KamilWuu/Robal-2.0/docs/math/47e88c19-b6d4-4813-9f29-f112e6b49282.pdf

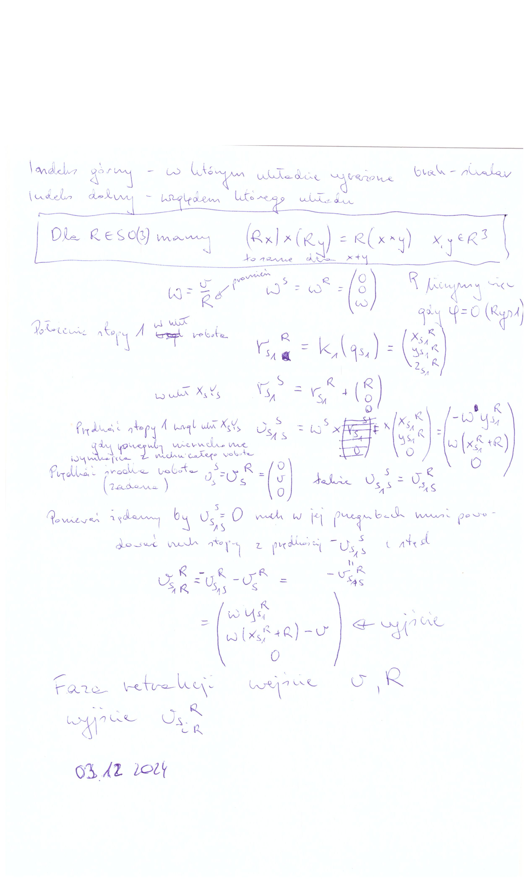
[picture p1: page 1]
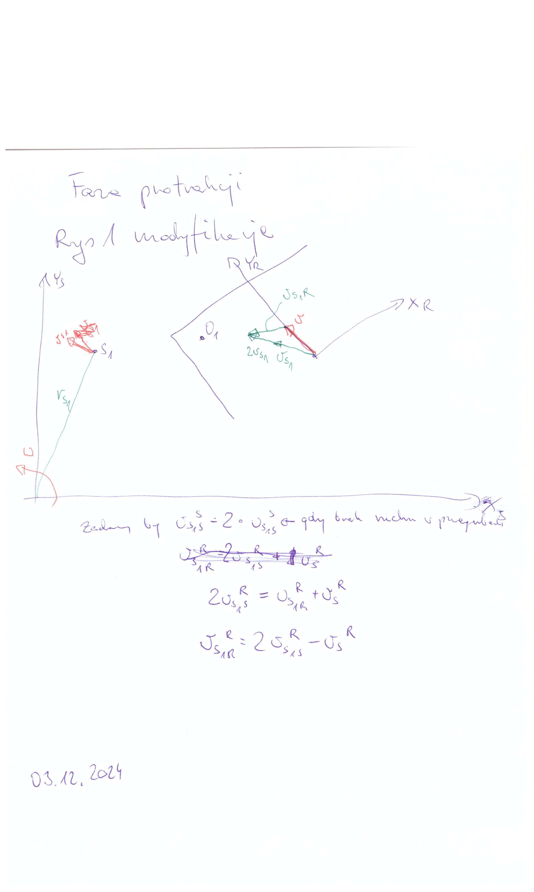
[picture p2: page 2]
