KamilWuu/Robal-2.0/docs/pictures/robal_power_board.png

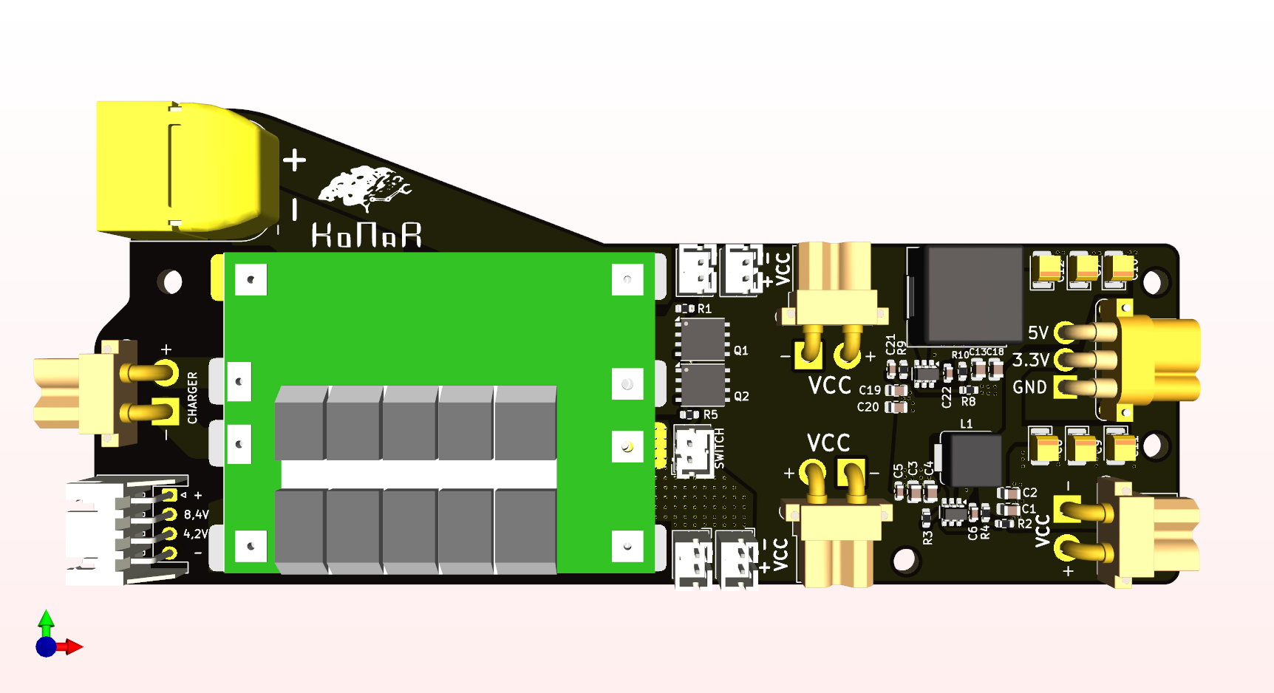
docs/pictures/robal_power_board.png
