KamilWuu/Robal-2.0/docs/pictures/robal_power_board_4.png

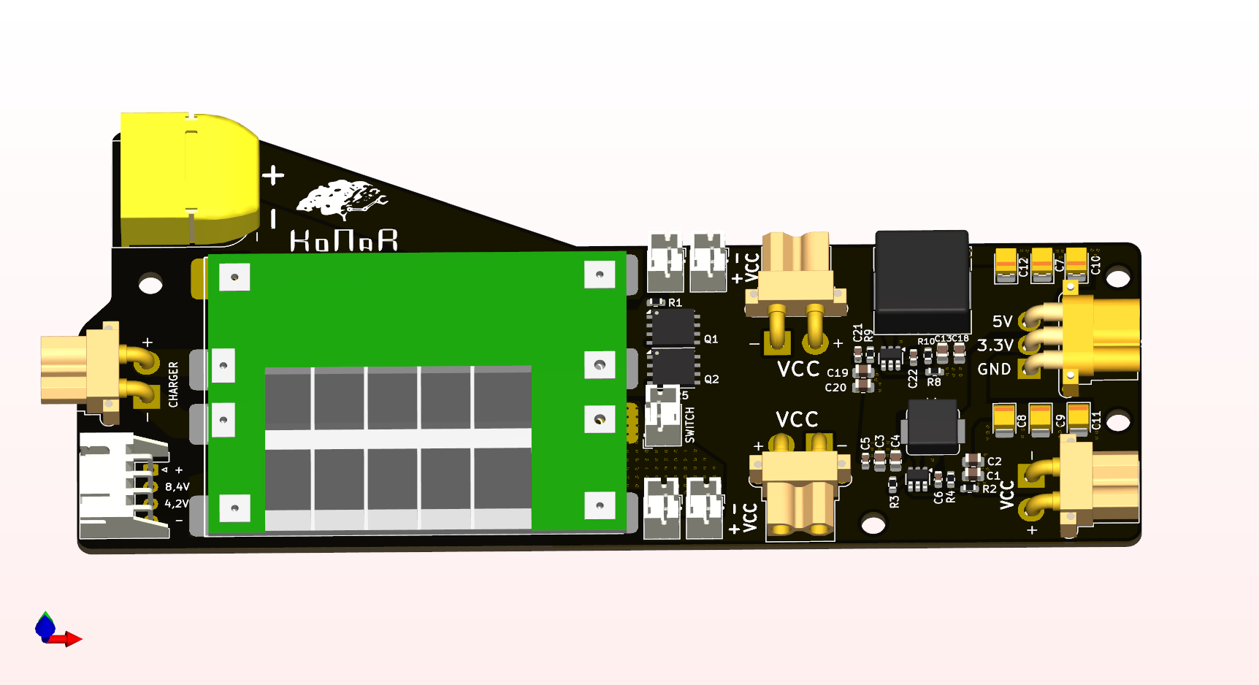
docs/pictures/robal_power_board_4.png
