KamilWuu/Robal-2.0/docs/pictures/robal_rpi_ioBoard_4.png

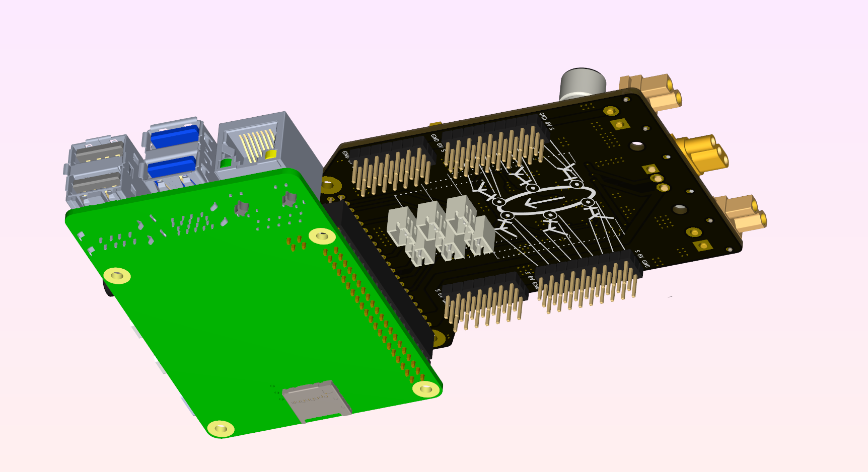
docs/pictures/robal_rpi_ioBoard_4.png
