KamilWuu/Robal-2.0/electronics/robal_power_board/5vsd_sketch.dxf

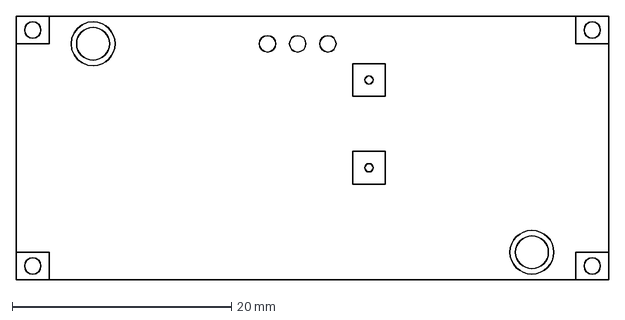
[picture p12: CAD file, 2024-07-06]
electronics/robal_power_board/5vsd_sketch.dxf
54.0 x 24.0 mm
