KamilWuu/Robal-2.0/electronics/robal_rpi_ioBoard/robal_rpi_ioBoard.step

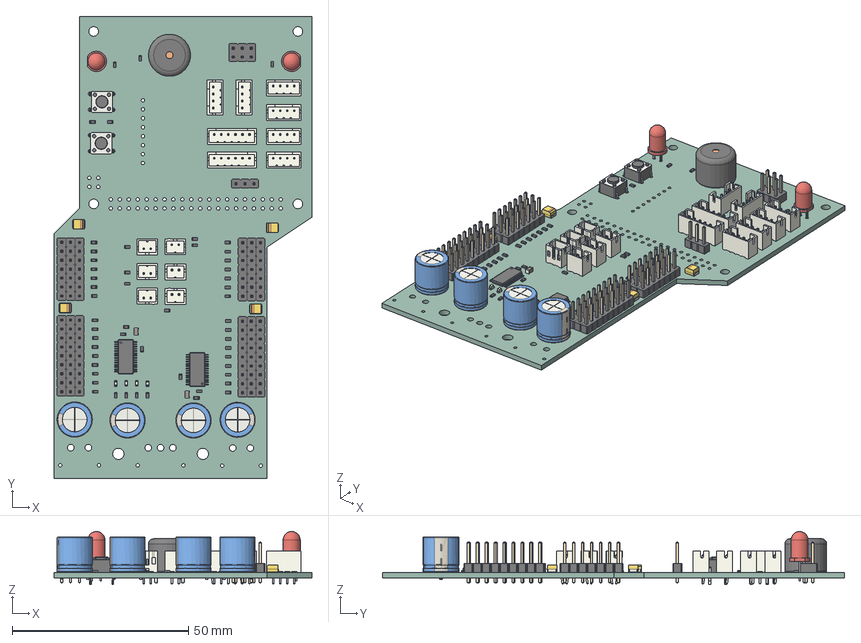
[picture p13: CAD file, 2024-08-12]
electronics/robal_rpi_ioBoard/robal_rpi_ioBoard.step
73.2 x 131.2 x 15.1 mm
R_0603_1608Metric x 53
LED_0603_1608Metric x 4
CP_EIA_3528_21_Kemet_B x 4
PinHeader_1x03_P254mm_Vertical
PinHeader_1x09_P254mm_Vertical x 6
PinHeader_1x07_P254mm_Vertical x 6
JST_B4B_PH_K x 6
LED_D5.0mm x 2
JST_B2B_PH_K x 6
JST_B6B_PH_K x 2
C_0805_2012Metric x 2
CP_Radial_D100mm_P750mm x 4
PinHeader_2x03_P254mm_Vertical
Buzzer_12x95RM76
SW_PUSH_6mm x 2
TSSOP_28_44x97mm_P065mm x 2
robal_rpi_ioBoard_PCB
