KamilWuu/Robal-2.0/electronics/step/MR30PW-FB v2.step

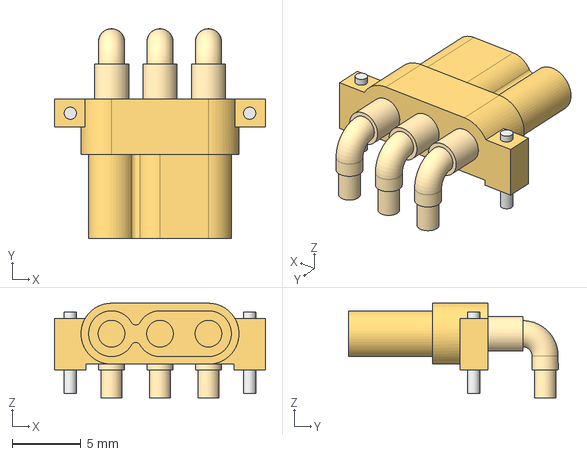
[picture p14: CAD file, 2024-07-27]
electronics/step/MR30PW-FB v2.step
15.3 x 15.2 x 6.87 mm
