KamilWuu/Robal-2.0/mechanics/mini_robal/podstawa.stl

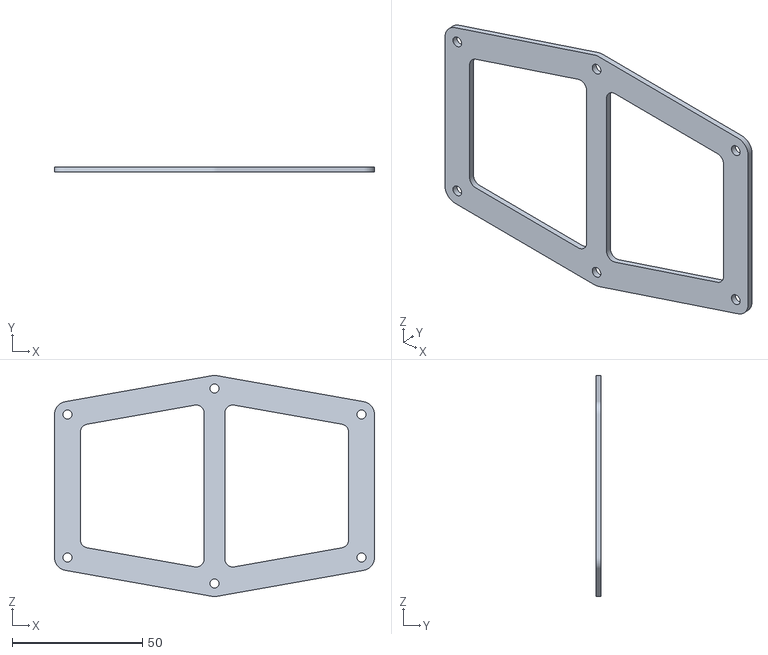
[picture p15: CAD file, 2024-10-20]
mechanics/mini_robal/podstawa.stl
123.0 x 2.00 x 85.0
