KamilWuu/Robal-2.0/mechanics/step/robal_power_board_7.step

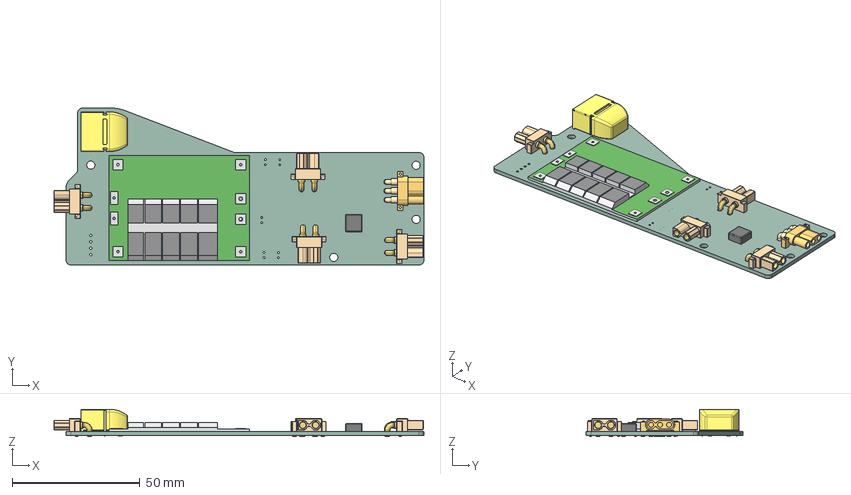
[picture p16: CAD file, 2024-09-15]
mechanics/step/robal_power_board_7.step
144.7 x 61.4 x 10.7 mm
CQ assembly
User Library-XT30PW-F x 4
60A3S_BMS
XT60PW MALE
MR30PW-FB v1
robal_power_board_PCB
