KamilWuu/Robal-2.0/mechanics/STL/but.stl

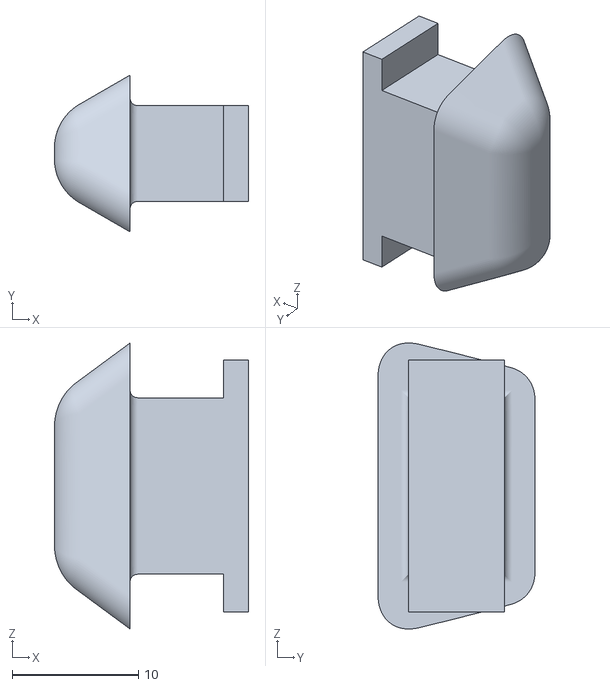
[picture p17: CAD file, 2024-12-04]
mechanics/STL/but.stl
15.4 x 12.4 x 22.7
