KamilWuu/Robal-2.0/mechanics/XT60E-M.STEP

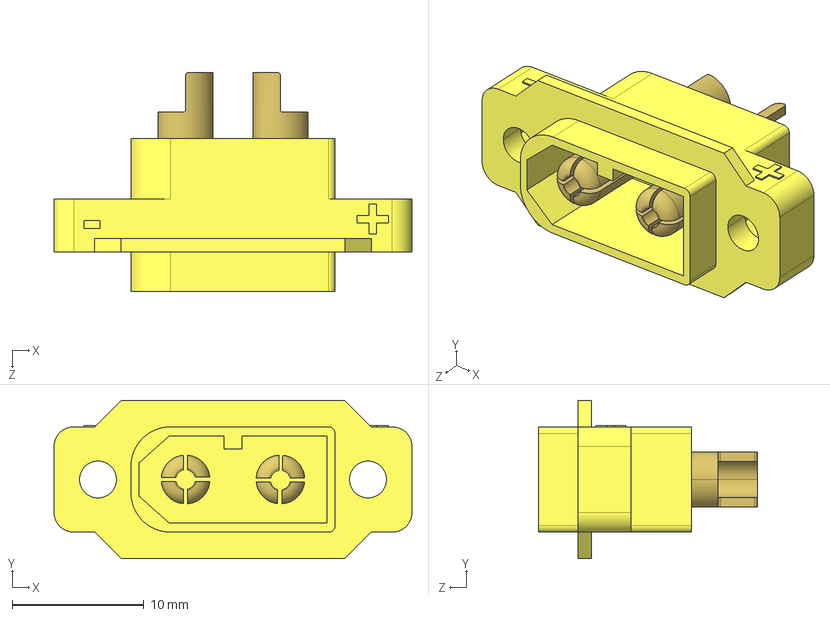
[picture p18: CAD file, 2024-10-20]
mechanics/XT60E-M.STEP
27.2 x 12.0 x 16.6 mm
