KamilWuu/Robal-2.0/electronics/robal_power_board/bms_sketch.dxf

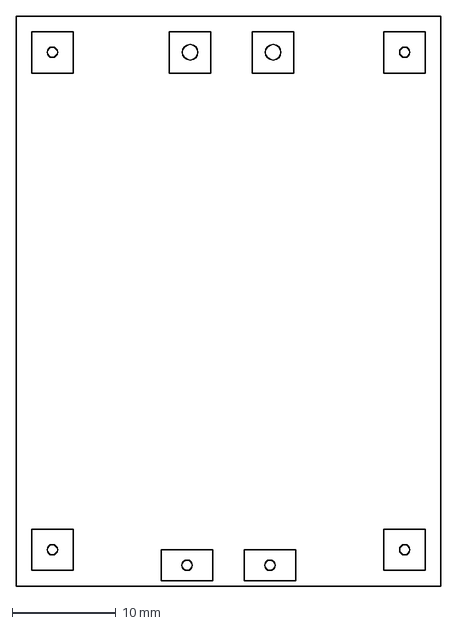
[picture p19: CAD file, 2024-07-06]
electronics/robal_power_board/bms_sketch.dxf
41.0 x 55.0 mm
