KamilWuu/Robal-2.0/electronics/step/XT30PW-F.STEP

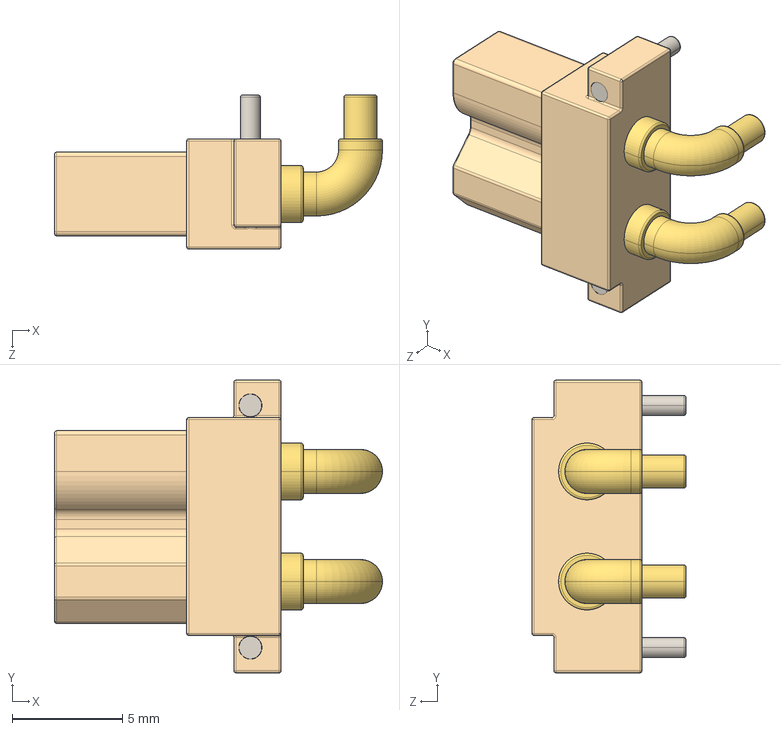
[picture p20: CAD file, 2024-07-27]
electronics/step/XT30PW-F.STEP
14.9 x 13.3 x 7.00 mm
