KamilWuu/Robal-2.0/mechanics/mini_robal/mini_noga.stl

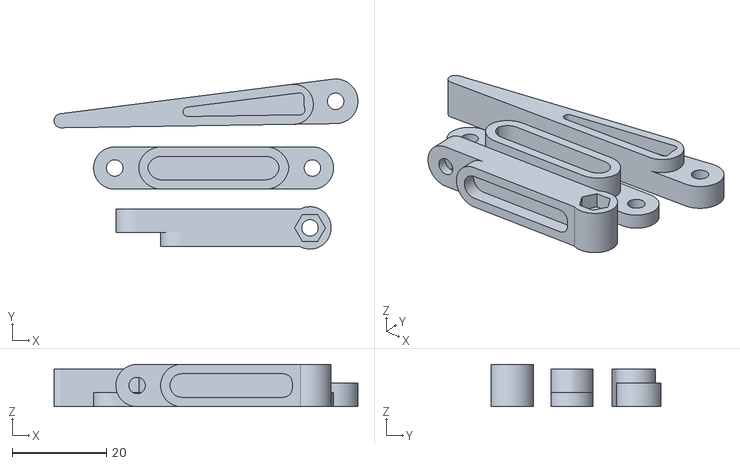
[picture p21: CAD file, 2024-10-20]
mechanics/mini_robal/mini_noga.stl
64.6 x 36.1 x 9.00
