KamilWuu/Robal-2.0/mechanics/rpi_board_obrys.dxf

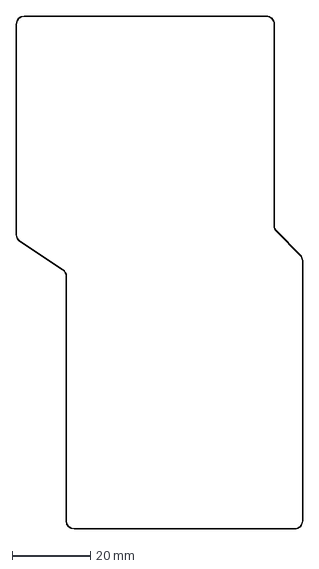
[picture p22: CAD file, 2024-08-12]
mechanics/rpi_board_obrys.dxf
73.3 x 131.2 mm
