KamilWuu/Robal-2.0/mechanics/STL/dol.stl

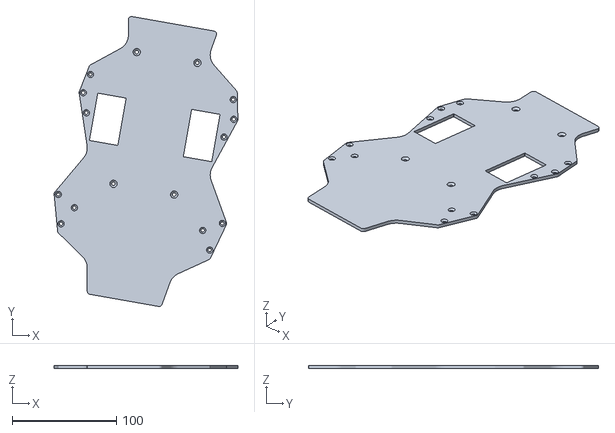
[picture p23: CAD file, 2024-10-29]
mechanics/STL/dol.stl
175.9 x 277.6 x 3.00
