KamilWuu/Robal-2.0/electronics/step/cewka.stp

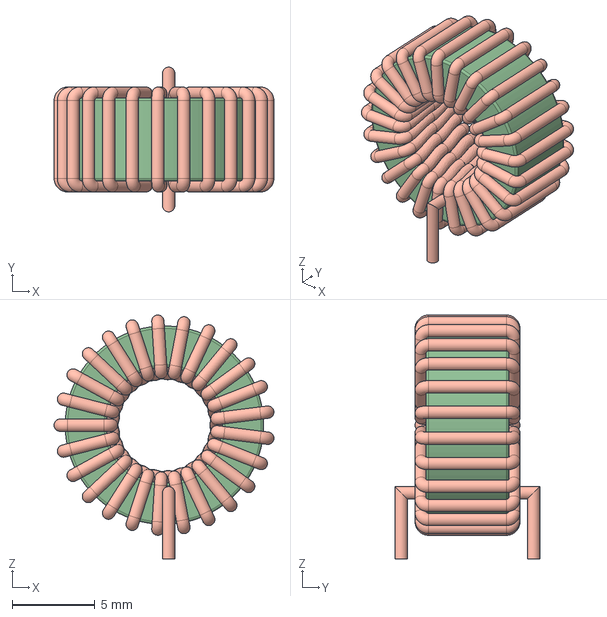
[picture p24: CAD file, 2024-07-13]
electronics/step/cewka.stp
13.3 x 8.75 x 14.8 mm
