KamilWuu/Robal-2.0/mechanics/Micro Limit Switch.STEP

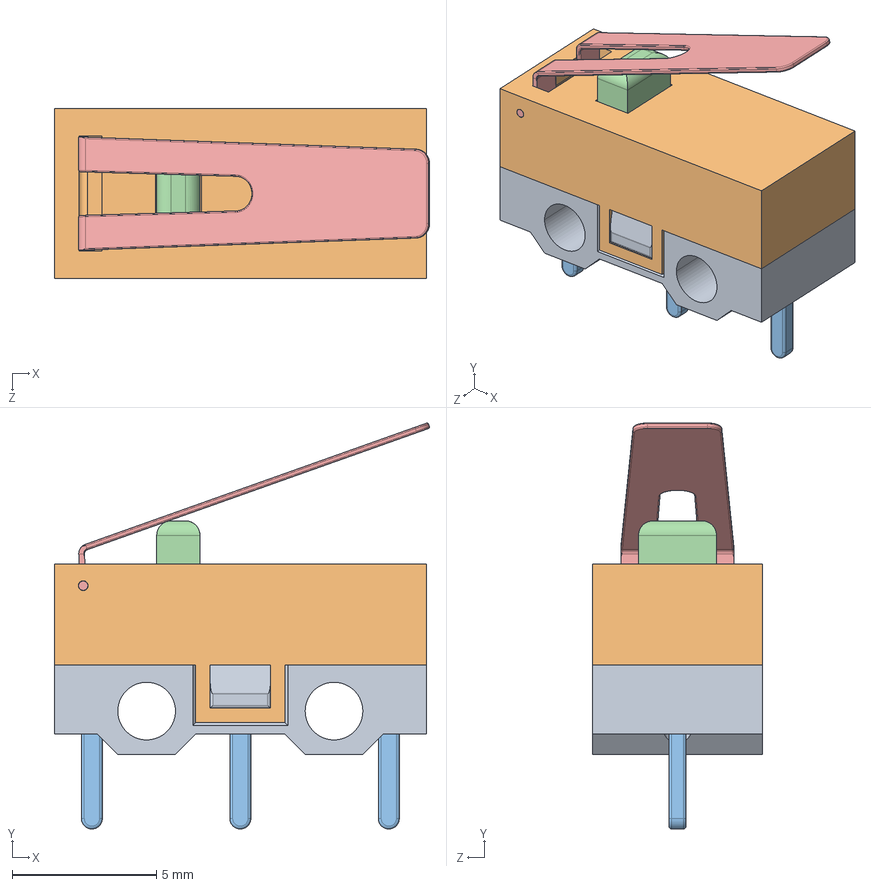
[picture p25: CAD file, 2024-07-24]
mechanics/Micro Limit Switch.STEP
13.0 x 14.1 x 5.90 mm
Bottom
Top
Pins x 3
Button
Lever
