KamilWuu/Robal-2.0/mechanics/STL/gora.stl

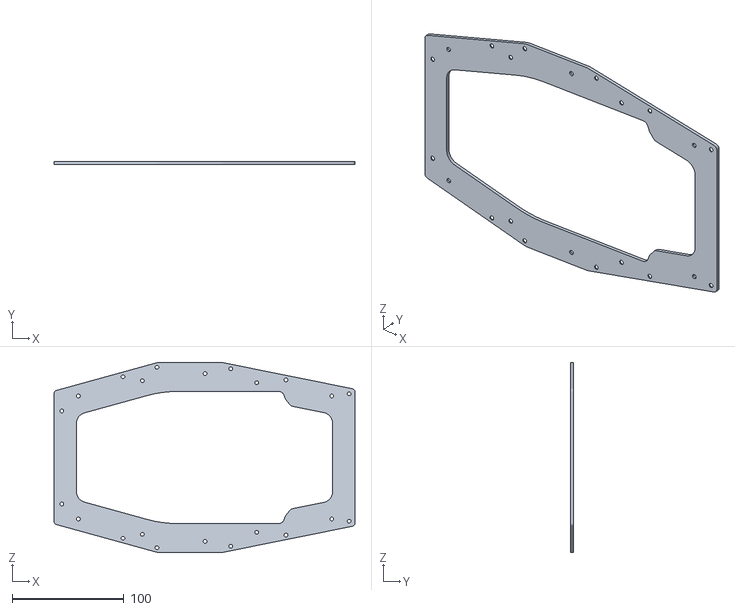
[picture p26: CAD file, 2024-10-29]
mechanics/STL/gora.stl
269.1 x 2.60 x 170.0
