KamilWuu/Robal-2.0/electronics/step/XT60PW FEMALE.STEP

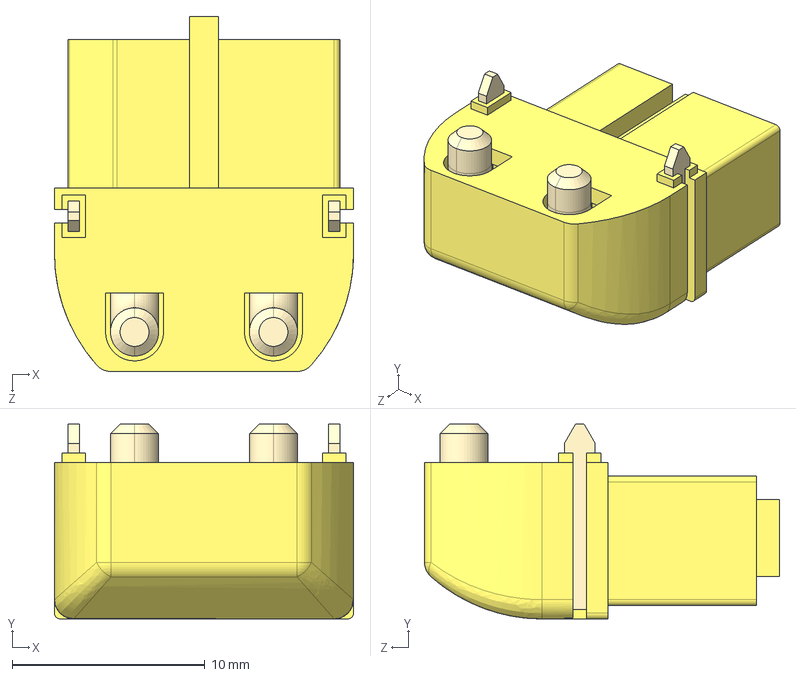
[picture p27: CAD file, 2024-07-06]
electronics/step/XT60PW FEMALE.STEP
15.5 x 10.1 x 18.4 mm
