KamilWuu/Robal-2.0/mechanics/60A3S_BMS.stp

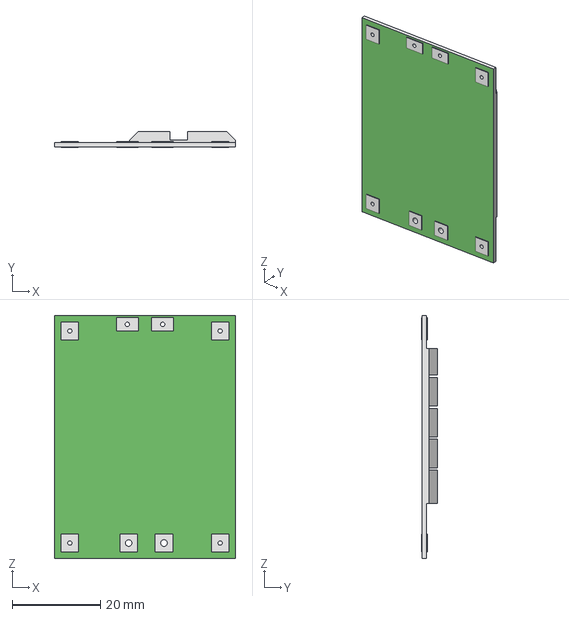
[picture p28: CAD file, 2024-07-06]
mechanics/60A3S_BMS.stp
41.0 x 3.70 x 55.0 mm
