KamilWuu/Robal-2.0/mechanics/STL/pokrywa.3mf

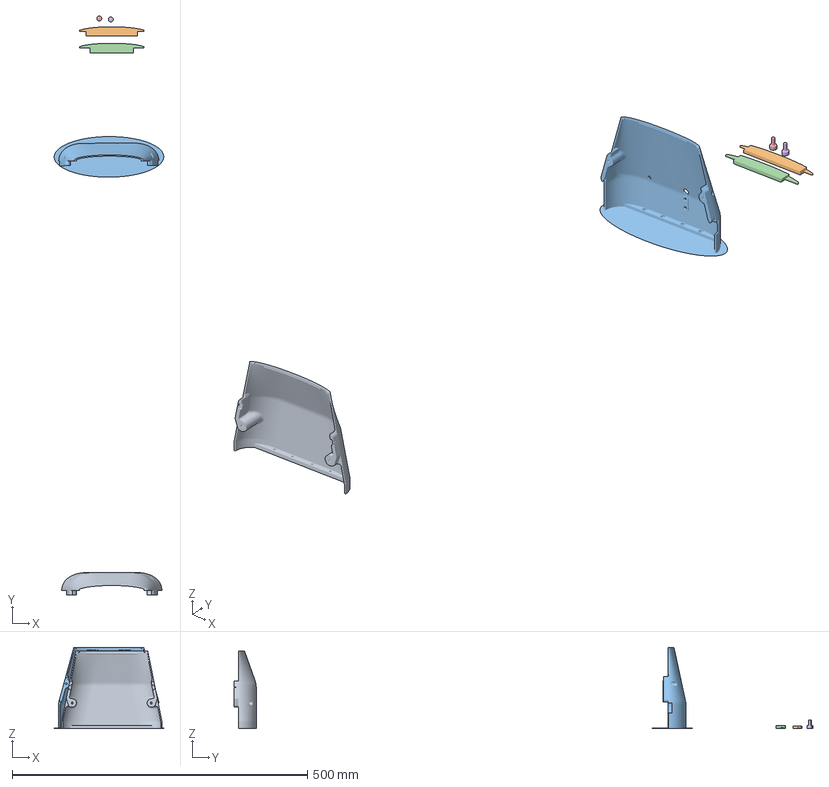
[picture p29: CAD file, 2024-10-27]
mechanics/STL/pokrywa.3mf
185.7 x 980.9 x 137.7 mm
pokrywa.stl_B
pokrywa_gorna_tyl.stl
Assembly
pokrywa_gorna_przod.stl
przycisk.stl x 2
