KamilWuu/Robal-2.0/electronics/step/Amass_XT30PW-M_pcb solder.stp

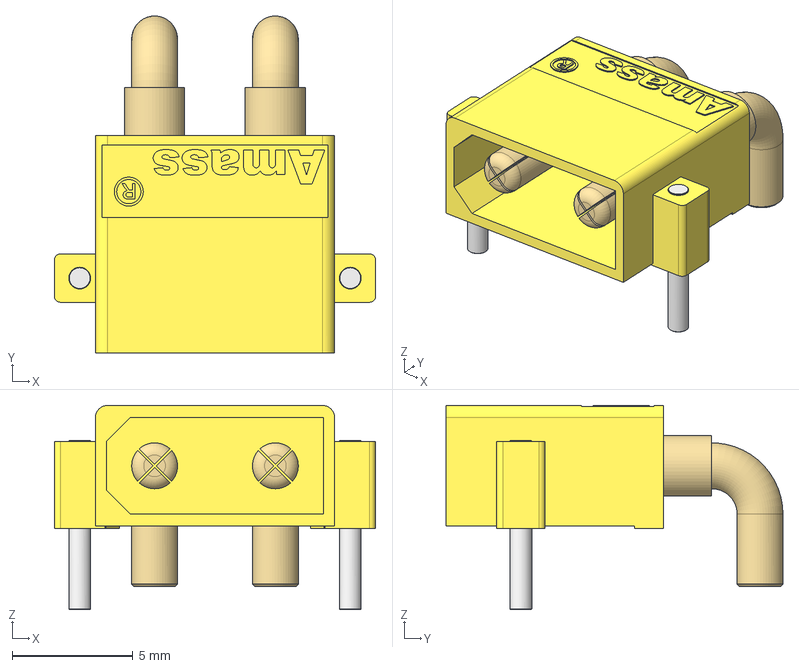
[picture p30: CAD file, 2024-07-06]
electronics/step/Amass_XT30PW-M_pcb solder.stp
13.3 x 13.9 x 8.45 mm
