KamilWuu/Robal-2.0/mechanics/STL/pokrywa_gorna_tyl.stl

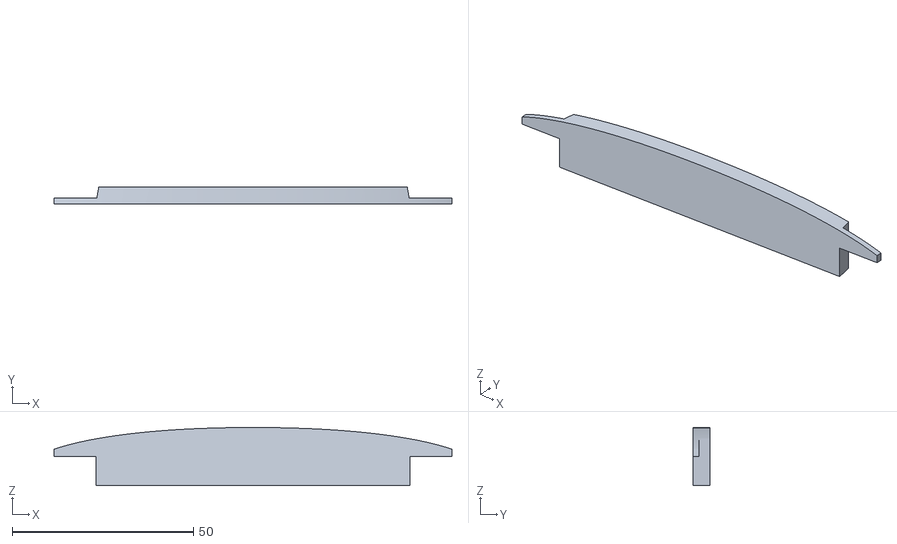
[picture p31: CAD file, 2024-10-27]
mechanics/STL/pokrywa_gorna_tyl.stl
109.7 x 4.58 x 16.0
