KamilWuu/Robal-2.0/electronics/step/MR30PW.step

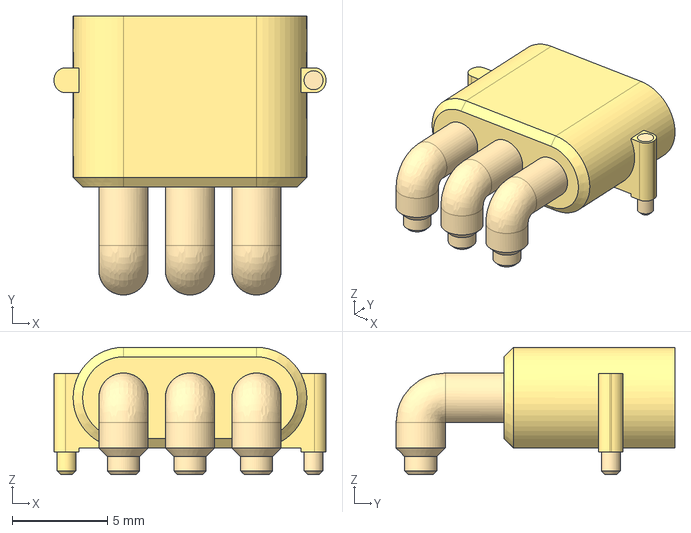
[picture p32: CAD file, 2024-07-06]
electronics/step/MR30PW.step
14.3 x 14.7 x 6.70 mm
