KamilWuu/Robal-2.0/mechanics/STL/pokrywa_gorna_przod.stl

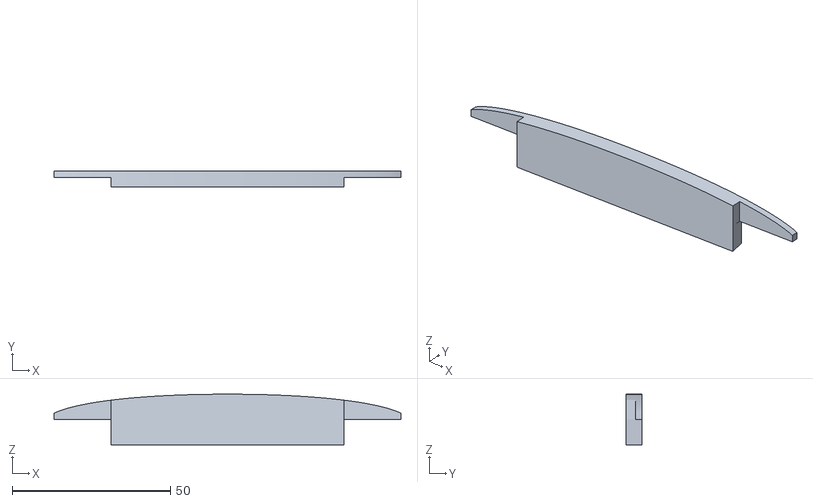
[picture p33: CAD file, 2024-10-27]
mechanics/STL/pokrywa_gorna_przod.stl
109.6 x 5.00 x 16.0
