KamilWuu/Robal-2.0/electronics/step/XT60PW MALE.STEP

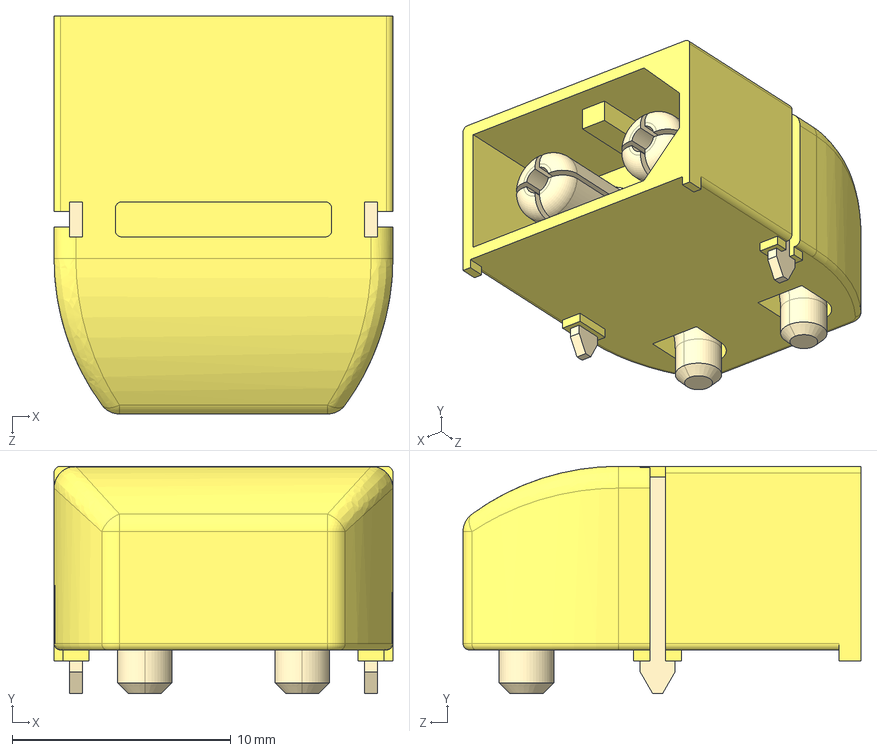
[picture p34: CAD file, 2024-07-06]
electronics/step/XT60PW MALE.STEP
15.5 x 10.4 x 18.2 mm
