KamilWuu/Robal-2.0/mechanics/STL/przycisk.stl

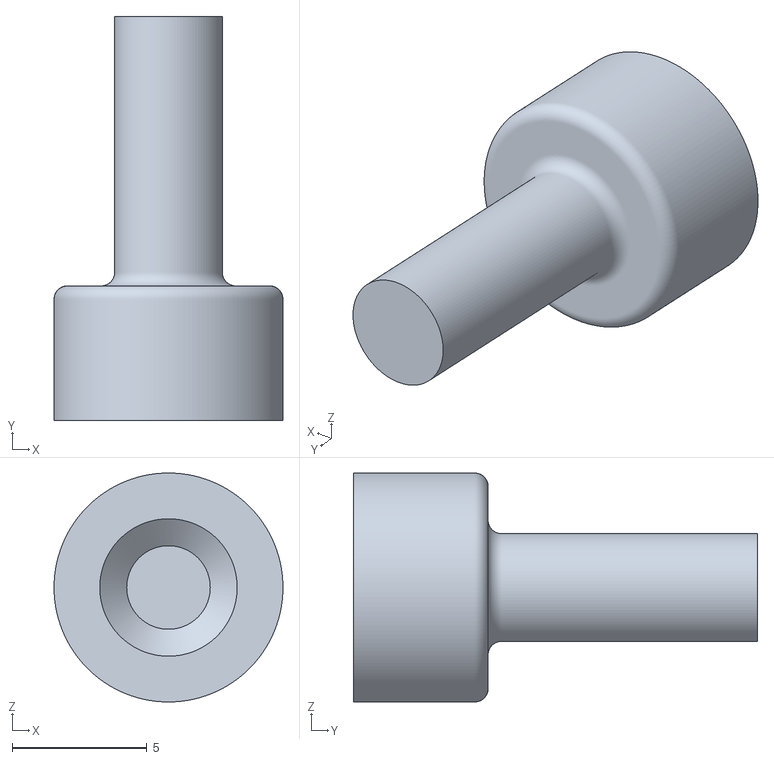
[picture p35: CAD file, 2024-10-27]
mechanics/STL/przycisk.stl
8.50 x 15.0 x 8.50
