KamilWuu/Robal-2.0/mechanics/STL/pokrywa_tyl.stl

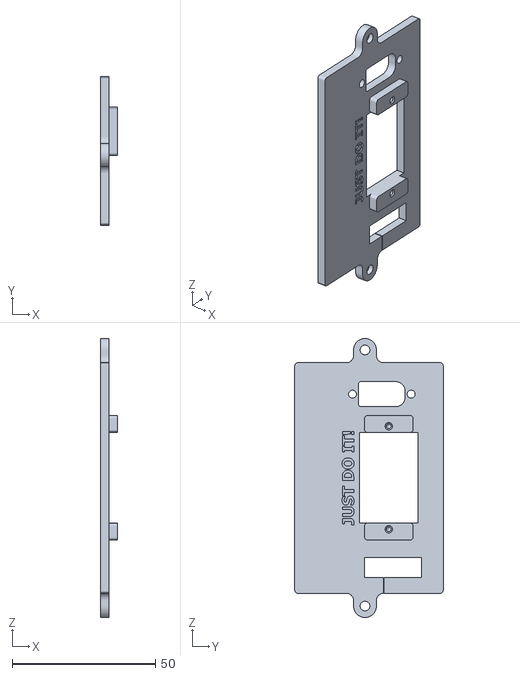
[picture p36: CAD file, 2024-10-20]
mechanics/STL/pokrywa_tyl.stl
6.00 x 51.9 x 97.5
