KamilWuu/Robal-2.0/mechanics/STL/oslona_wlacznika.stl

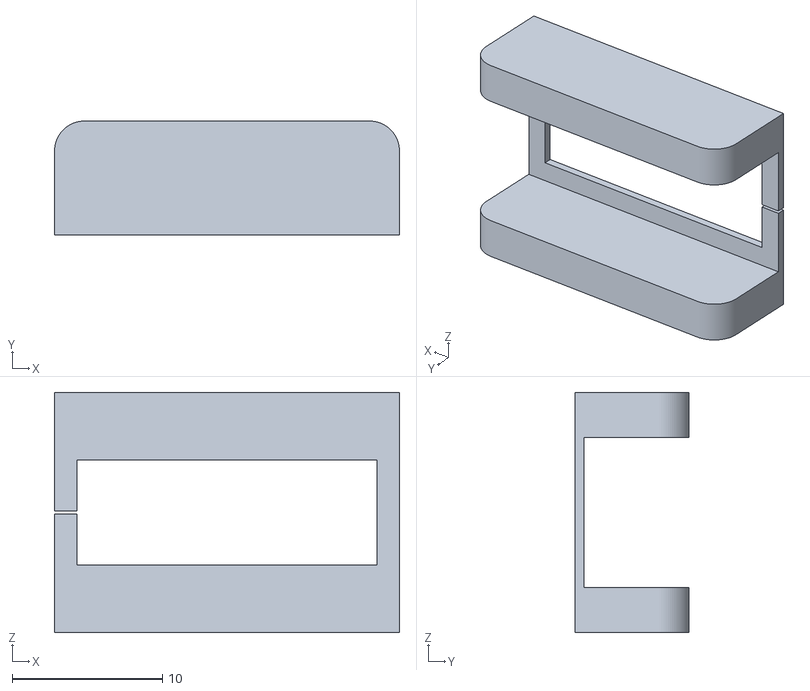
[picture p37: CAD file, 2024-10-20]
mechanics/STL/oslona_wlacznika.stl
23.0 x 7.60 x 16.0
