KamilWuu/Robal-2.0/mechanics/STL/podstawka_bateria.stl

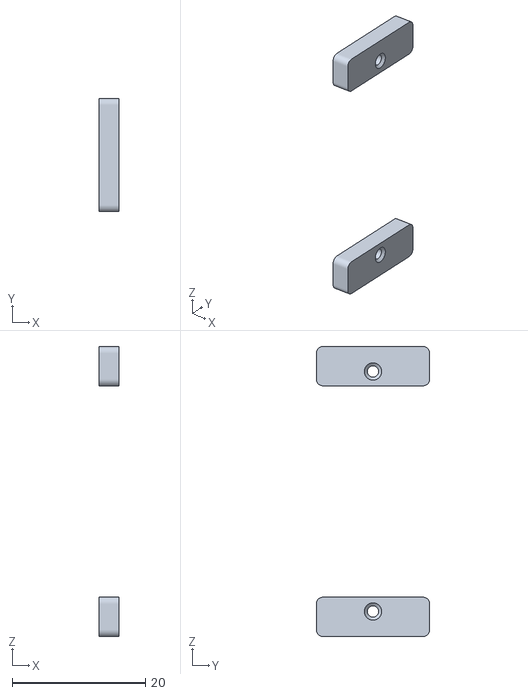
[picture p38: CAD file, 2024-10-20]
mechanics/STL/podstawka_bateria.stl
3.00 x 17.0 x 43.5
