KamilWuu/Robal-2.0/mechanics/STL/podpora_imu.stl

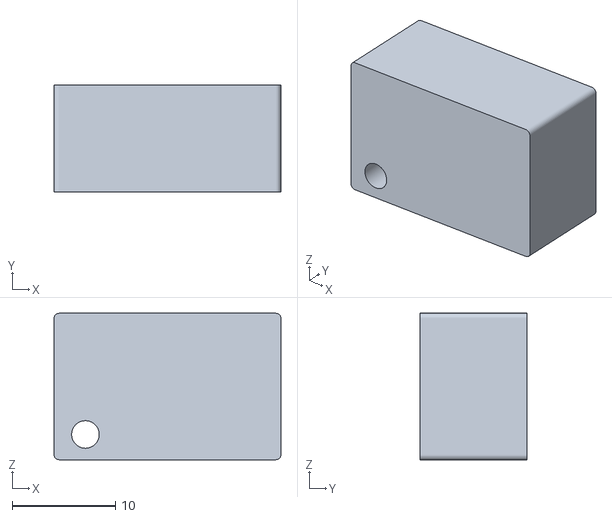
[picture p39: CAD file, 2024-10-12]
mechanics/STL/podpora_imu.stl
22.0 x 10.4 x 14.2
