KamilWuu/Robal-2.0/mechanics/STL/podstawa_rpi_1.stl

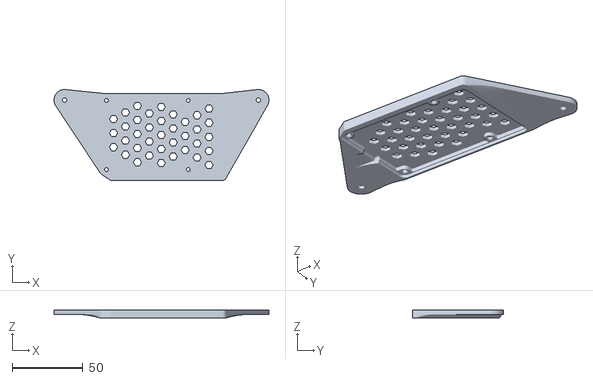
[picture p40: CAD file, 2024-09-15]
mechanics/STL/podstawa_rpi_1.stl
152.4 x 64.5 x 5.50
