KamilWuu/Robal-2.0/mechanics/STL/podstawa_rpi_board_2.stl

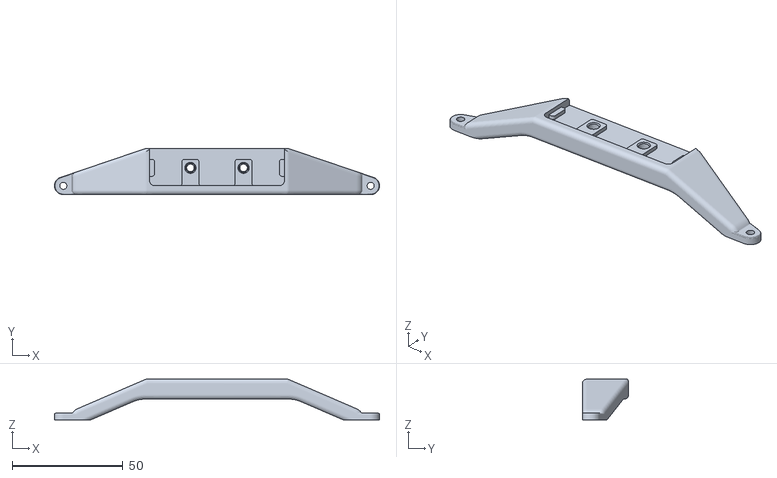
[picture p41: CAD file, 2024-09-15]
mechanics/STL/podstawa_rpi_board_2.stl
146.7 x 20.9 x 18.4
