KamilWuu/Robal-2.0/mechanics/STL/rpi_wspornik.stl

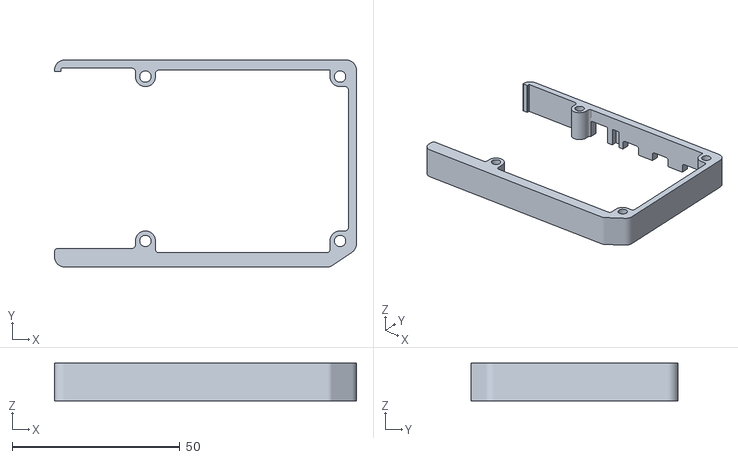
[picture p42: CAD file, 2024-09-15]
mechanics/STL/rpi_wspornik.stl
90.0 x 61.7 x 11.2
