KamilWuu/Robal-2.0/mechanics/STL/klips.stl

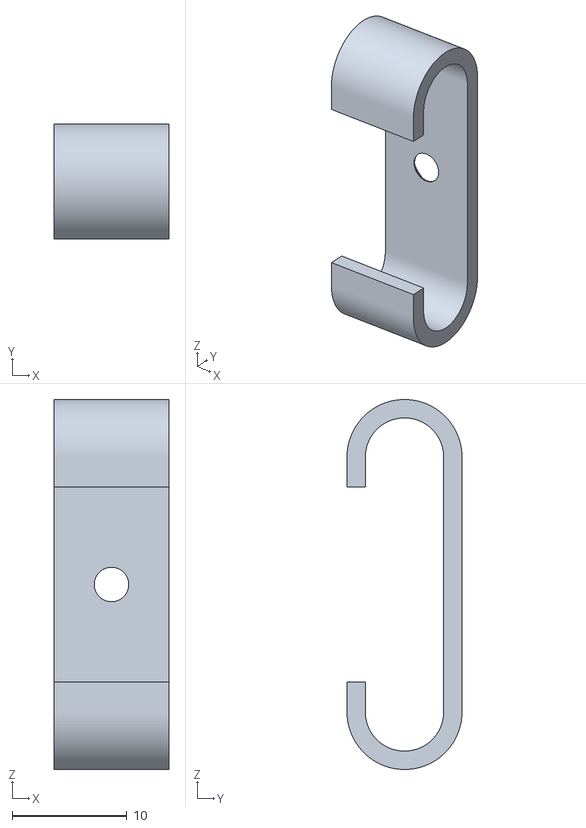
[picture p43: CAD file, 2024-08-08]
mechanics/STL/klips.stl
10.0 x 10.0 x 32.2
