KamilWuu/Robal-2.0/mechanics/STL/czlon3_lewy.3mf

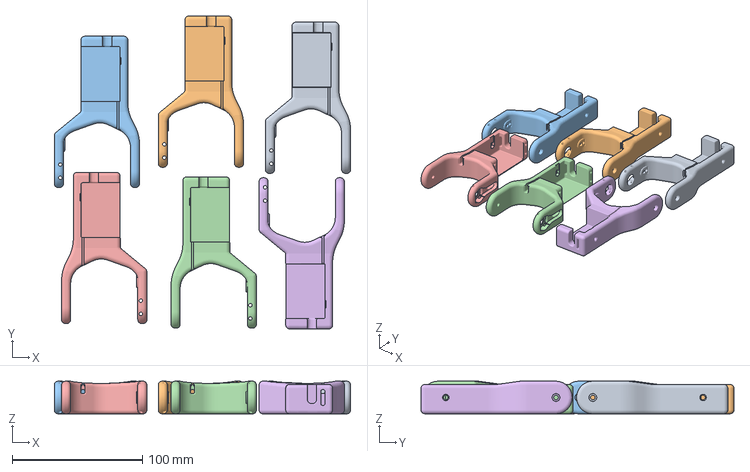
[picture p44: CAD file, 2024-08-08]
mechanics/STL/czlon3_lewy.3mf
227.2 x 240.0 x 25.0 mm
czlon2_lewy x 6
