KamilWuu/Robal-2.0/mechanics/STL/organizer_1.3mf

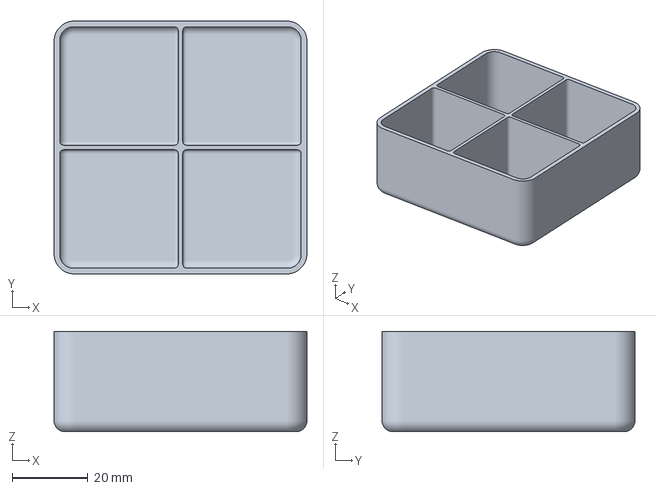
[picture p45: CAD file, 2024-08-08]
mechanics/STL/organizer_1.3mf
66.6 x 66.6 x 26.5 mm
