KamilWuu/Robal-2.0/mechanics/STL/ochraniach_1.stl

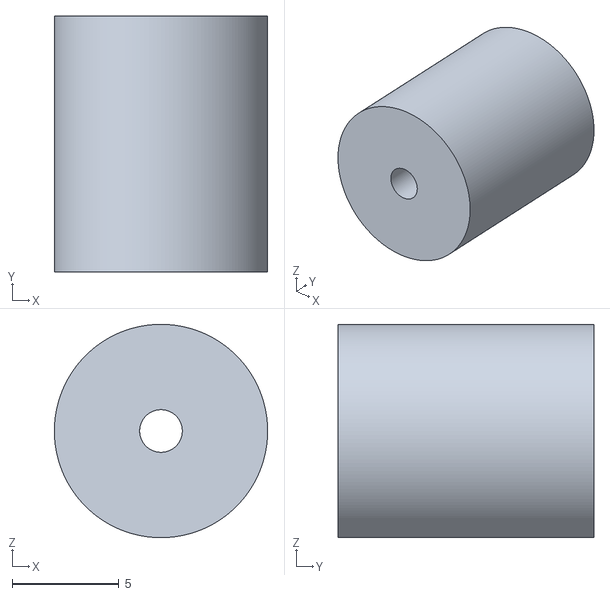
[picture p46: CAD file, 2024-08-08]
mechanics/STL/ochraniach_1.stl
10.0 x 12.0 x 10.0
