KamilWuu/Robal-2.0/mechanics/STL/czlon2_lewy.3mf

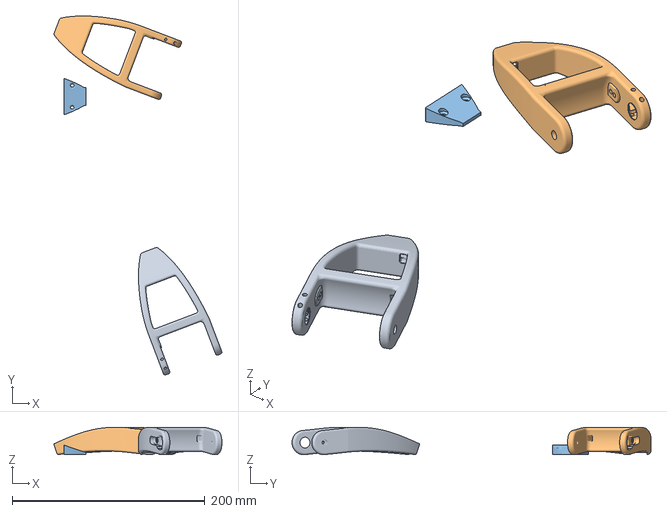
[picture p47: CAD file, 2024-08-08]
mechanics/STL/czlon2_lewy.3mf
174.1 x 372.2 x 28.2 mm
czlon3_lewy x 2
czlon3_lewy_pokrywa.stl
