KamilWuu/Robal-2.0/mechanics/STL/ochraniach_2.stl

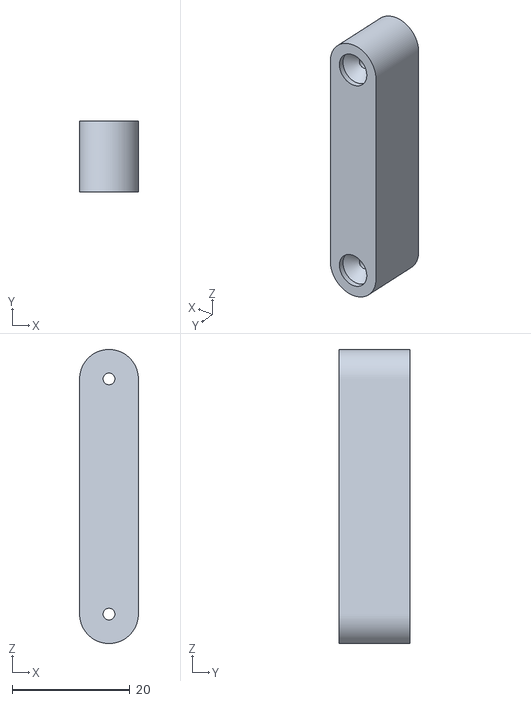
[picture p48: CAD file, 2024-08-08]
mechanics/STL/ochraniach_2.stl
10.0 x 12.0 x 50.0
