KamilWuu/Robal-2.0/mechanics/STL/kulka.stl

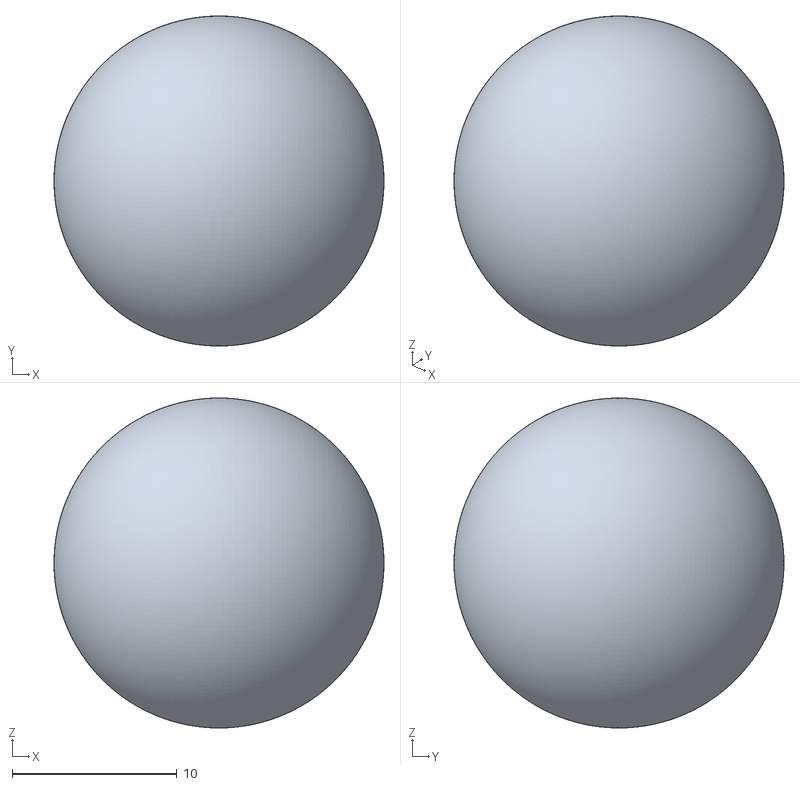
[picture p49: CAD file, 2024-08-08]
mechanics/STL/kulka.stl
20.0 x 20.0 x 20.0
