KamilWuu/Robal-2.0/mechanics/STL/uchwyt_li_pol.stl

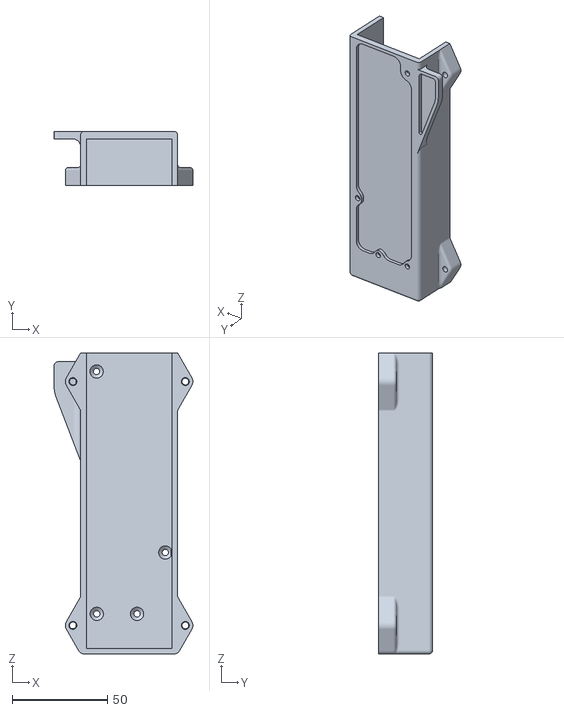
[picture p50: CAD file, 2024-08-08]
mechanics/STL/uchwyt_li_pol.stl
72.9 x 28.5 x 158.0
