KamilWuu/Robal-2.0/mechanics/STL/angle_servo.stl

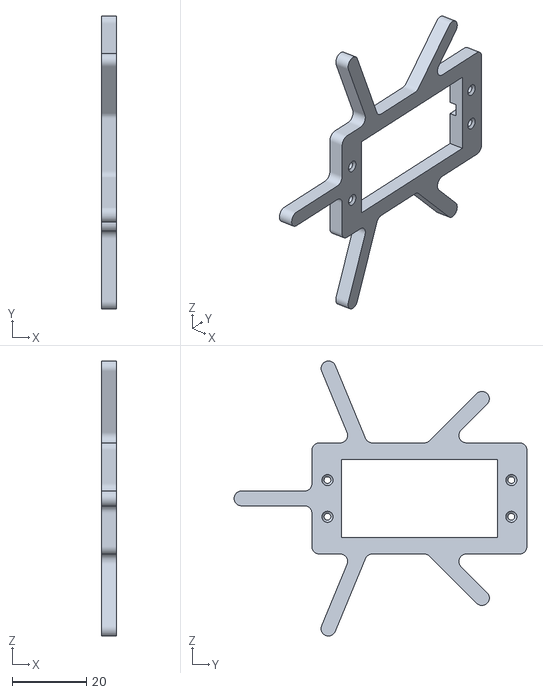
[picture p51: CAD file, 2024-08-08]
mechanics/STL/angle_servo.stl
4.00 x 79.0 x 74.2
