KamilWuu/Robal-2.0/mechanics/STL/podkladka_switch.stl

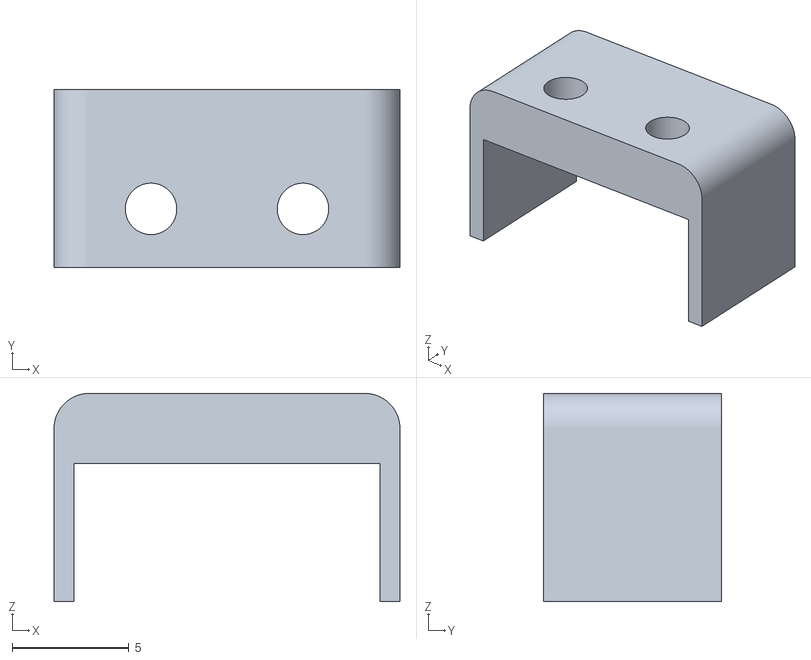
[picture p52: CAD file, 2024-08-08]
mechanics/STL/podkladka_switch.stl
14.8 x 7.60 x 8.90
