KamilWuu/Robal-2.0/mechanics/STL/czlon3_lewy_pokrywa.stl

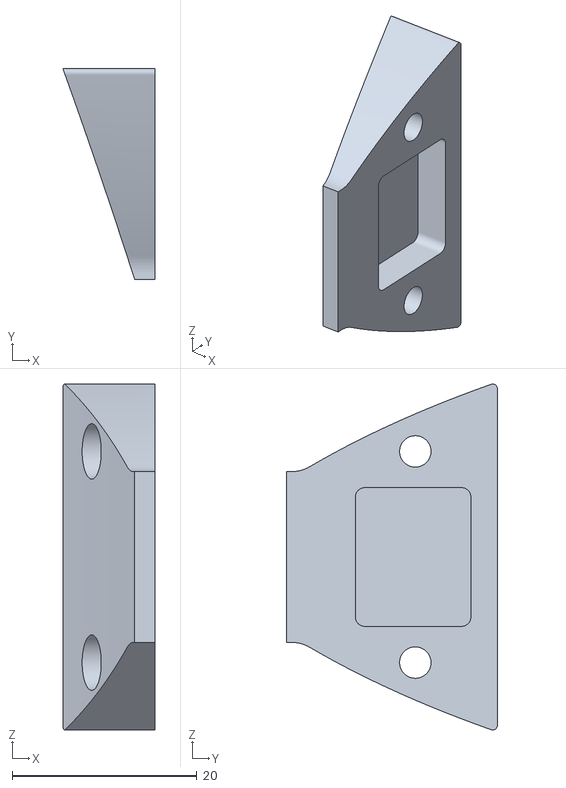
[picture p53: CAD file, 2024-08-08]
mechanics/STL/czlon3_lewy_pokrywa.stl
9.98 x 22.8 x 37.4
