KamilWuu/Robal-2.0/mechanics/STL/czlon3_lewy_color_1.stl

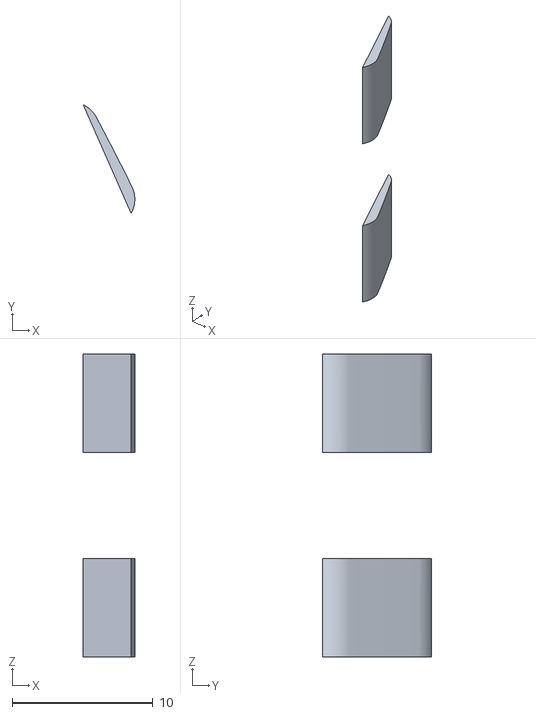
[picture p54: CAD file, 2024-08-05]
mechanics/STL/czlon3_lewy_color_1.stl
3.67 x 7.70 x 21.5
