KamilWuu/Robal-2.0/mechanics/STL/czlon2_lewy_color_2.stl

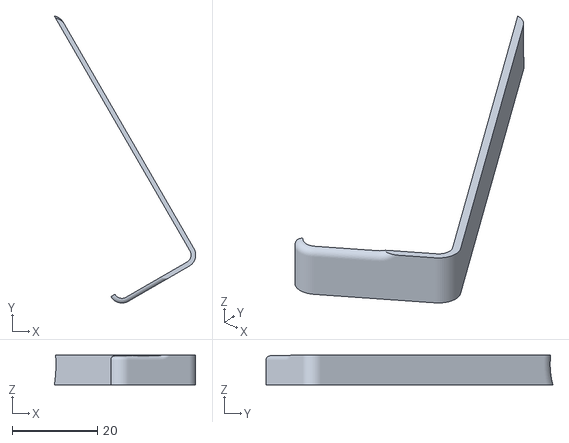
[picture p55: CAD file, 2024-08-02]
mechanics/STL/czlon2_lewy_color_2.stl
33.1 x 67.3 x 7.00
