KamilWuu/Robal-2.0/mechanics/STL/czlon2_lewy_color_1.stl

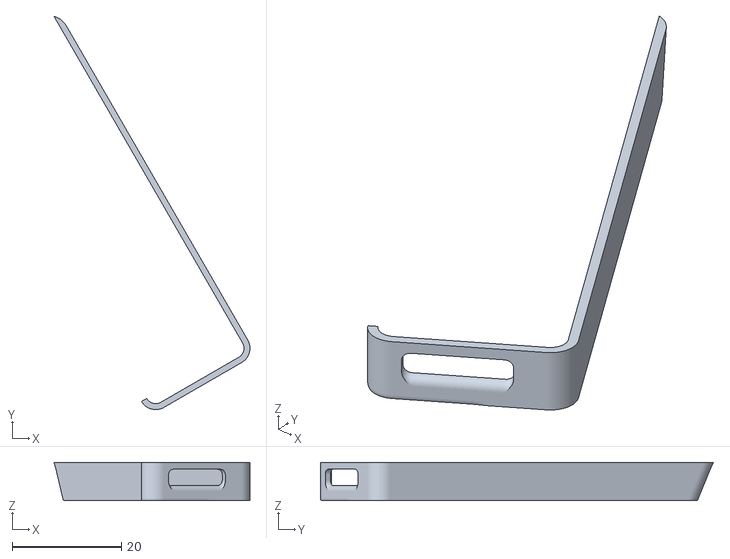
[picture p56: CAD file, 2024-08-02]
mechanics/STL/czlon2_lewy_color_1.stl
35.9 x 72.1 x 7.00
