KamilWuu/Robal-2.0/mechanics/STL/czlon1_lewy_color_3.stl

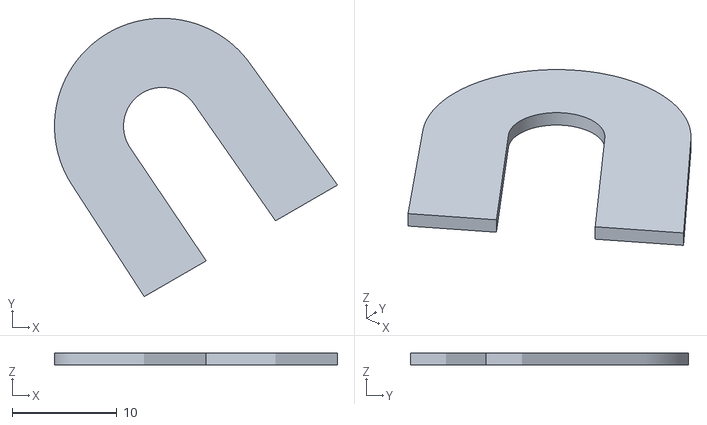
[picture p57: CAD file, 2024-07-31]
mechanics/STL/czlon1_lewy_color_3.stl
27.0 x 26.6 x 1.10
