KamilWuu/Robal-2.0/mechanics/STL/czlon1_lewy.stl

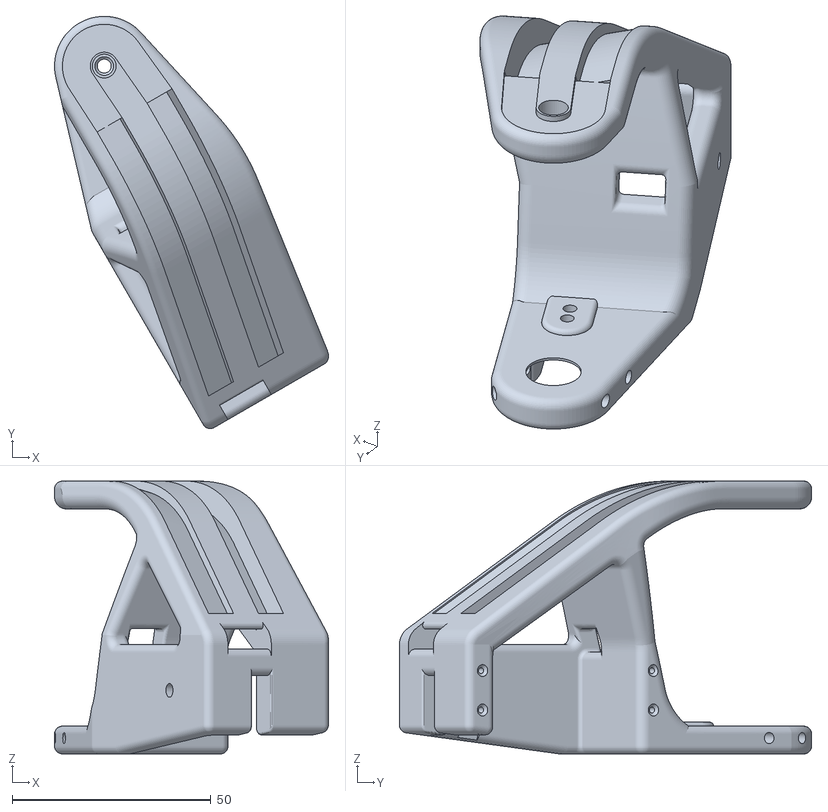
[picture p58: CAD file, 2024-07-31]
mechanics/STL/czlon1_lewy.stl
68.9 x 103.6 x 68.6
