KamilWuu/Robal-2.0/mechanics/STL/uchwyt_serwa_podwojny.3mf

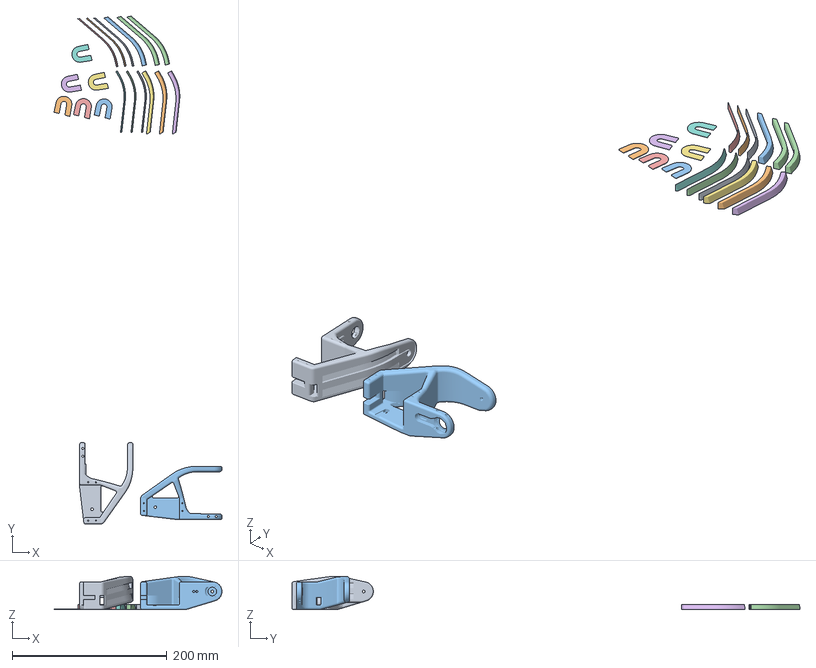
[picture p59: CAD file, 2024-07-31]
mechanics/STL/uchwyt_serwa_podwojny.3mf
216.9 x 655.7 x 43.1 mm
czlon1_prawy.stl
czlon1_lewy_color_2.stl x 6
czlon1_lewy.stl
czlon1_lewy_color_1.stl x 6
czlon1_lewy_color_3.stl x 6
