KamilWuu/Robal-2.0/mechanics/STL/czlon1_lewy_color_2.stl

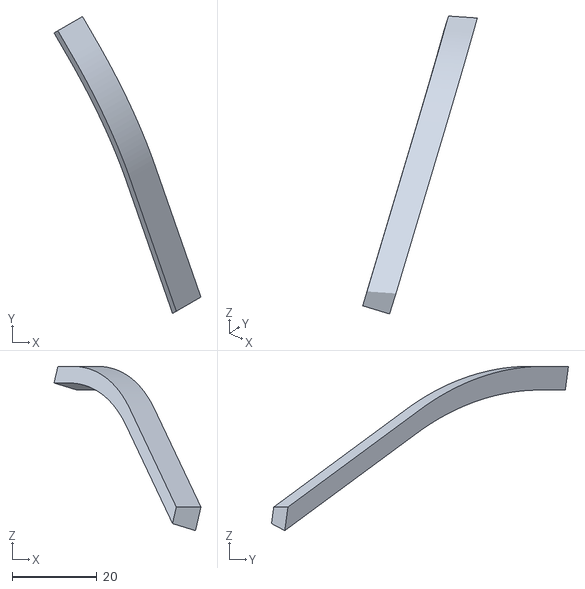
[picture p60: CAD file, 2024-07-31]
mechanics/STL/czlon1_lewy_color_2.stl
34.8 x 70.3 x 38.9
