KamilWuu/Robal-2.0/mechanics/STL/czlon1_lewy_color_1.stl

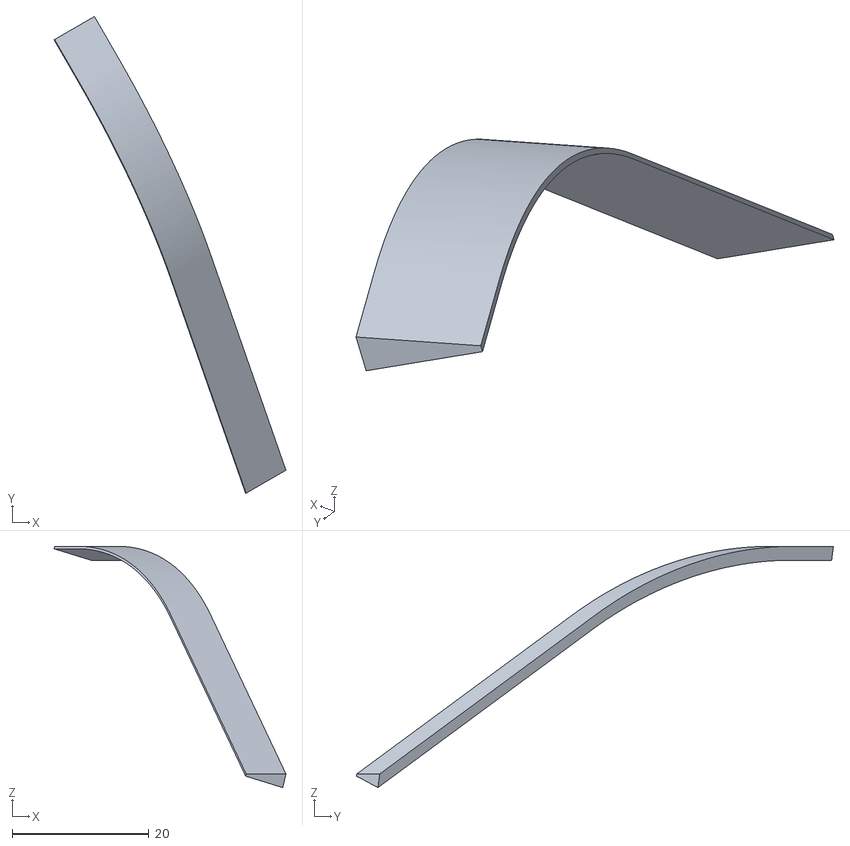
[picture p61: CAD file, 2024-07-31]
mechanics/STL/czlon1_lewy_color_1.stl
33.9 x 69.8 x 35.3
