KamilWuu/Robal-2.0/mechanics/STL/usztywnienie_3.stl

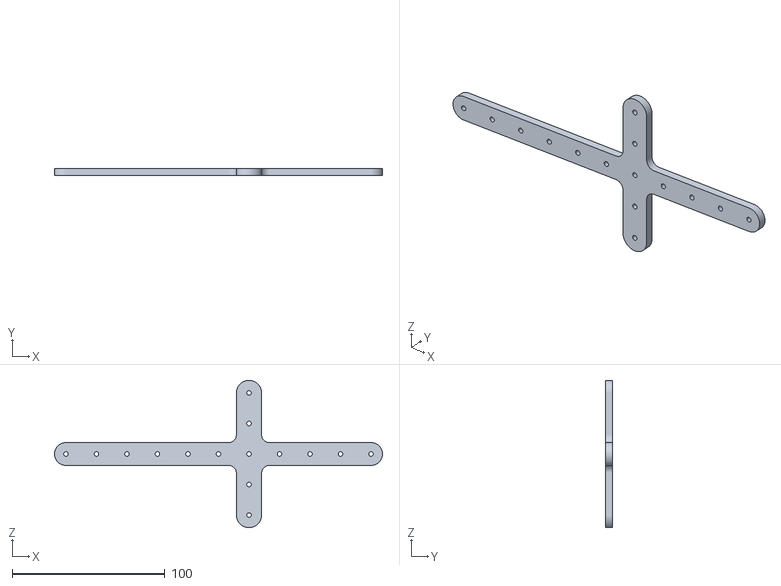
[picture p62: CAD file, 2024-07-31]
mechanics/STL/usztywnienie_3.stl
215.0 x 4.80 x 96.6
