KamilWuu/Robal-2.0/mechanics/STL/uchwyt_serwa_podwojny_MIR.stl

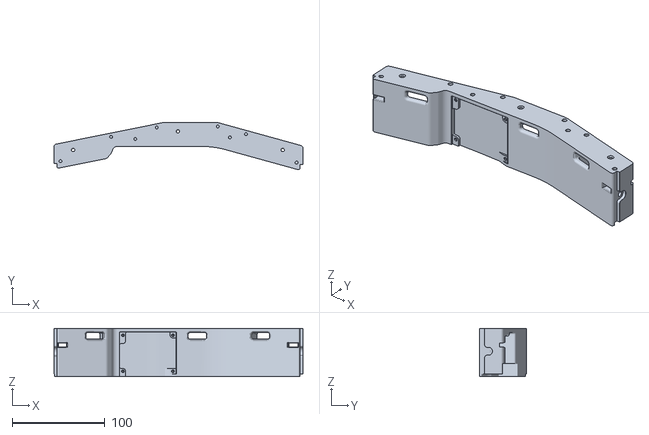
[picture p63: CAD file, 2024-07-31]
mechanics/STL/uchwyt_serwa_podwojny_MIR.stl
269.1 x 51.1 x 52.0
