KamilWuu/Robal-2.0/mechanics/STL/usztywnienie.stl

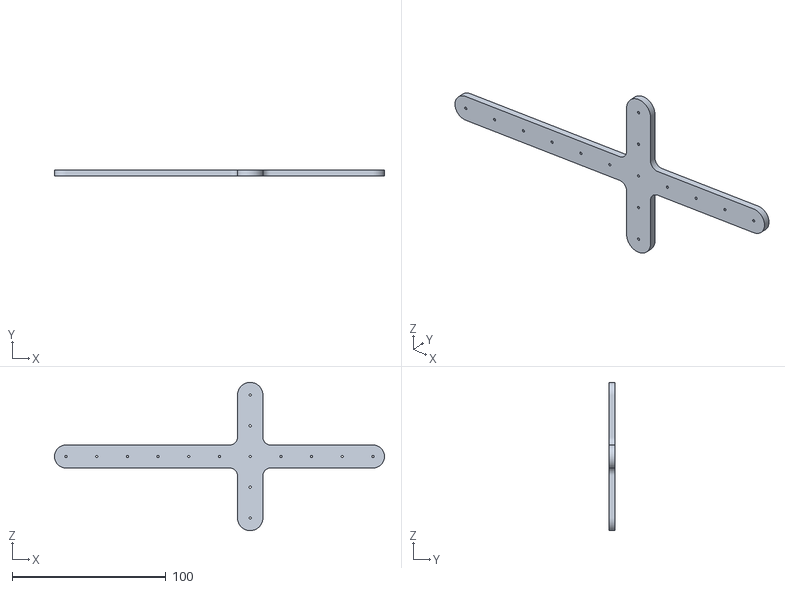
[picture p65: CAD file, 2024-07-31]
mechanics/STL/usztywnienie.stl
215.0 x 4.00 x 96.6
