KamilWuu/Robal-2.0/mechanics/STL/pokrywa_przod.stl

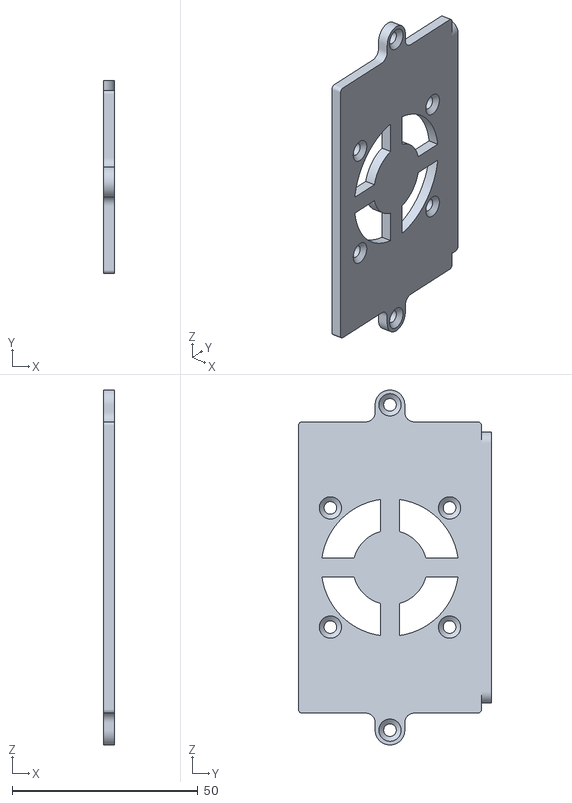
[picture p66: CAD file, 2024-07-31]
mechanics/STL/pokrywa_przod.stl
3.00 x 52.0 x 95.6
