KamilWuu/Robal-2.0/(list of files, cad)

Other CAD files:
docs/drawings/noga_pre_MIR.dwg
mechanics/STL/czlon3_lewy_but.stl
docs/drawings/OldVersions/noga_pre_MIR.0001.dwg
mechanics/60A3S_BMS.ipt
mechanics/Bashing_3S1P_11.1V_5000mAH_60c.ipt
mechanics/DC-DC Step Down Buck Converter CC-CV 300W 9A.ipt
mechanics/Lithium Battery Capacity Indicator Module.ipt
mechanics/Micro Limit Switch/Micro Limit Switch.ipt
mechanics/Micro Limit Switch/Micro Limit Switch_MIR.ipt
mechanics/Micro Limit Switch/Micro Limit Switch_MIR1.ipt
mechanics/Micro Limit Switch/OldVersions/Micro Limit Switch.0002.ipt
mechanics/OldVersions/60A3S_BMS.0001.ipt
mechanics/OldVersions/Bashing_3S1P_11.1V_5000mAH_60c.0001.ipt
mechanics/OldVersions/Lithium Battery Capacity Indicator Module.0001.ipt
mechanics/OldVersions/POKRYWA_TYLNA.0001.iam
mechanics/OldVersions/ROBAL_2.0_assembly_01.0017.iam
mechanics/OldVersions/RPI.0004.iam
mechanics/OldVersions/RPI_2.0009.iam
mechanics/OldVersions/Standard-Servo.0011.ipt
mechanics/OldVersions/Standard-Servo_MIR3.0001.ipt
mechanics/OldVersions/blacha_dolna_pre.0003.ipt
mechanics/OldVersions/blacha_gorna_pre.0002.ipt
mechanics/OldVersions/but.0007.ipt
mechanics/OldVersions/but_MIR1.0001.ipt
mechanics/OldVersions/cewka.0003.ipt
mechanics/OldVersions/czlon2_pre.0020.ipt
mechanics/OldVersions/czlon2_pre_MIR2.0003.ipt
mechanics/OldVersions/czlon2_pre_dol.0004.ipt
mechanics/OldVersions/czlon3_pre.0023.ipt
mechanics/OldVersions/czlon3_pre_MIR1.0004.ipt
mechanics/OldVersions/czlon4_2_wciecie_1.0003.ipt
mechanics/OldVersions/czlon4_pre.0003.ipt
mechanics/OldVersions/czlon4_pre_2.0018.ipt
mechanics/OldVersions/czlon4_pre_2_MIR1.0002.ipt
mechanics/OldVersions/czlon4_pre_2_pokrywa.0009.ipt
mechanics/OldVersions/czlon_2_wciecie_1.0005.ipt
mechanics/OldVersions/czlon_2_wciecie_2.0005.ipt
mechanics/OldVersions/czlon_2_wciecie_3.0003.ipt
mechanics/OldVersions/czlon_3_wciecie_1.0004.ipt
mechanics/OldVersions/czlon_3_wciecie_1_MIR.0001.ipt
mechanics/OldVersions/czlon_3_wciecie_2.0004.ipt
mechanics/OldVersions/czlon_3_wciecie_2_MIR.0001.ipt
mechanics/OldVersions/czlon_4_zloz.0009.iam
mechanics/OldVersions/czlon_4_zloz_MIR.0002.iam
mechanics/OldVersions/czlon_4_zloz_MIR1.0001.iam
mechanics/OldVersions/dol.0009.ipt
mechanics/OldVersions/gora.0016.ipt
mechanics/OldVersions/noga_pre.0030.iam
mechanics/OldVersions/noga_pre_MIR.0003.iam
mechanics/OldVersions/noga_pre_MIR1.0008.iam
mechanics/OldVersions/noga_pre_MIR2.0001.iam
mechanics/OldVersions/noga_temp_pre.0004.ipt
mechanics/OldVersions/podstawa_rpi_1.0004.ipt
mechanics/OldVersions/podstawa_rpi_board_2.0001.ipt
mechanics/OldVersions/pokrywa_gora.0002.ipt
mechanics/OldVersions/pokrywa_gora_przod.0001.ipt
mechanics/OldVersions/pokrywa_gorna_przod.0001.ipt
mechanics/OldVersions/pokrywa_gorna_tyl.0001.ipt
mechanics/OldVersions/pokrywa_przod.0006.ipt
mechanics/OldVersions/pokrywa_tyl.0013.ipt
mechanics/OldVersions/rpi_wspornik.0004.ipt
mechanics/OldVersions/serwo_v2.0002.iam
mechanics/OldVersions/uchwyt_li_pol.0003.ipt
mechanics/OldVersions/uchwyt_serwa_czlon0_pre.0004.ipt
mechanics/OldVersions/uchwyt_serwa_czlon1_pre.0003.ipt
mechanics/OldVersions/uchwyt_serwa_podwojny.0026.ipt
mechanics/OldVersions/uchwyt_serwa_podwojny_MIR.0010.ipt
mechanics/POKRYWA_TYLNA.iam
mechanics/ROBAL_2.0_assembly_01.iam
mechanics/RPI_2.iam
mechanics/SERVO ARM HORN 25T ALUMINIUM/OldVersions/SERVO ARM HORN 25T ALUMINIUM.0002.ipt
mechanics/SERVO ARM HORN 25T ALUMINIUM/SERVO ARM HORN 25T ALUMINIUM.ipt
mechanics/SERVO ARM HORN 25T ALUMINIUM/SERVO ARM HORN 25T ALUMINIUM_MIR.ipt
mechanics/SERVO ARM HORN 25T ALUMINIUM/SERVO ARM HORN 25T ALUMINIUM_MIR1.ipt
mechanics/STL/OldVersions/klips.0001.ipt
mechanics/STL/OldVersions/oslona_wlacznika.0001.ipt
mechanics/STL/OldVersions/podkladka_switch.0002.ipt
mechanics/STL/Part3.ipt
mechanics/STL/czlon2_lewy.stl
mechanics/STL/czlon3_lewy.stl
mechanics/STL/klips.ipt
mechanics/STL/organizer_1.stl
mechanics/STL/oslona_wlacznika.ipt
mechanics/STL/podkladka_switch.ipt
mechanics/STL/podkladka_switch_MIR.ipt
mechanics/STL/podkladka_switch_MIR1.ipt
mechanics/STL/pokrywa.stl
mechanics/STL/przycisk.ipt
mechanics/STL/uchwyt_serwa_podwojny.stl
mechanics/STL/usztywnienie.ipt
mechanics/Standard-Servo.ipt
mechanics/Standard-Servo_MIR.ipt
mechanics/Standard-Servo_MIR1.ipt
mechanics/Standard-Servo_MIR2.ipt
mechanics/Standard-Servo_MIR3.ipt
mechanics/Sub-Assy Buck Converter.ipt
mechanics/XT60E-M/XT60E-M.ipt
mechanics/but.ipt
mechanics/but_MIR.ipt
mechanics/but_MIR1.ipt
mechanics/cewka.ipt
mechanics/czlon2_pre.ipt
mechanics/czlon2_pre_MIR.ipt
mechanics/czlon2_pre_MIR1.ipt
mechanics/czlon2_pre_MIR2.ipt
mechanics/czlon2_pre_dol.ipt
mechanics/czlon3_pre.ipt
mechanics/czlon3_pre_MIR.ipt
mechanics/czlon3_pre_MIR1.ipt
mechanics/czlon3_pre_MIR2.ipt
mechanics/czlon4_2_wciecie_1.ipt
mechanics/czlon4_2_wciecie_1_MIR.ipt
mechanics/czlon4_2_wciecie_1_MIR1.ipt
mechanics/czlon4_pre_2.ipt
mechanics/czlon4_pre_2_MIR.ipt
mechanics/czlon4_pre_2_MIR1.ipt
mechanics/czlon4_pre_2_MIR2.ipt
mechanics/czlon4_pre_2_pokrywa.ipt
mechanics/czlon4_pre_2_pokrywa_MIR.ipt
mechanics/czlon4_pre_2_pokrywa_MIR1.ipt
mechanics/czlon_2_wciecie_1.ipt
mechanics/czlon_2_wciecie_1_MIR.ipt
mechanics/czlon_2_wciecie_1_MIR1.ipt
mechanics/czlon_2_wciecie_2.ipt
mechanics/czlon_2_wciecie_2_MIR.ipt
mechanics/czlon_2_wciecie_2_MIR1.ipt
mechanics/czlon_2_wciecie_3.ipt
mechanics/czlon_2_wciecie_3_MIR.ipt
mechanics/czlon_2_wciecie_3_MIR1.ipt
mechanics/czlon_3_wciecie_1.ipt
mechanics/czlon_3_wciecie_1_MIR.ipt
mechanics/czlon_3_wciecie_1_MIR1.ipt
mechanics/czlon_3_wciecie_2.ipt
mechanics/czlon_3_wciecie_2_MIR.ipt
mechanics/czlon_3_wciecie_2_MIR1.ipt
mechanics/czlon_4_zloz.iam
mechanics/czlon_4_zloz_MIR.iam
mechanics/czlon_4_zloz_MIR1.iam
mechanics/dol.ipt
mechanics/gora.ipt
mechanics/li_pol_3S_5000mAh.ipt
mechanics/mini_robal/L1.ipt
mechanics/mini_robal/L2.ipt
mechanics/mini_robal/L3.ipt
mechanics/mini_robal/OldVersions/L1.0002.ipt
mechanics/mini_robal/OldVersions/L2.0002.ipt
mechanics/mini_robal/OldVersions/ROBAL_MINI.0002.iam
mechanics/mini_robal/OldVersions/pokrywa.0004.ipt
mechanics/mini_robal/ROBAL_MINI.iam
mechanics/mini_robal/podstawa.ipt
mechanics/noga_pre.iam
mechanics/noga_pre_MIR.iam
mechanics/noga_pre_MIR1.iam
mechanics/noga_pre_MIR2.iam
mechanics/podpora_imu.ipt
mechanics/podstawa_rpi_1.ipt
mechanics/podstawa_rpi_board_2.ipt
mechanics/pokrywa_gora.ipt
mechanics/pokrywa_gorna_przod.ipt
mechanics/pokrywa_gorna_tyl.ipt
mechanics/pokrywa_przod.ipt
mechanics/pokrywa_tyl.ipt
mechanics/rpi_wspornik.ipt
mechanics/step/robal_power_board_7/robal_power_board_7.ipt
mechanics/step/robal_power_board_new/robal_power_board_new.ipt
mechanics/uchwyt_li_pol.ipt
mechanics/uchwyt_serwa_podwojny.ipt
mechanics/uchwyt_serwa_podwojny_MIR.ipt
mechanics/zloz_2.iam
