KamilWuu/Robal-2.0/electronics/robal_rpi_ioBoard/robal_rpi_ioBoard.kicad_pcb

## KiCad design electronics/robal_rpi_ioBoard/robal_rpi_ioBoard.kicad_pcb (2024-12-04)

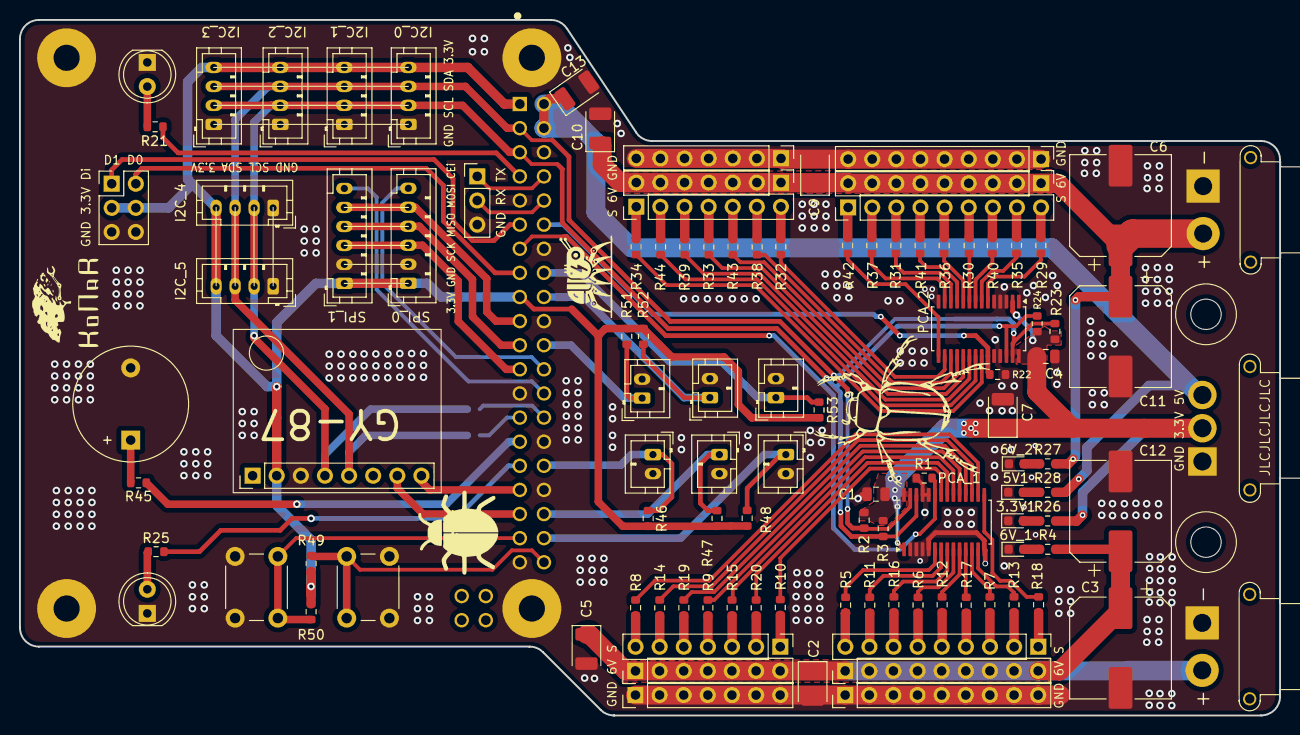
[picture p67: board robal_rpi_ioBoard.kicad_pcb from above]

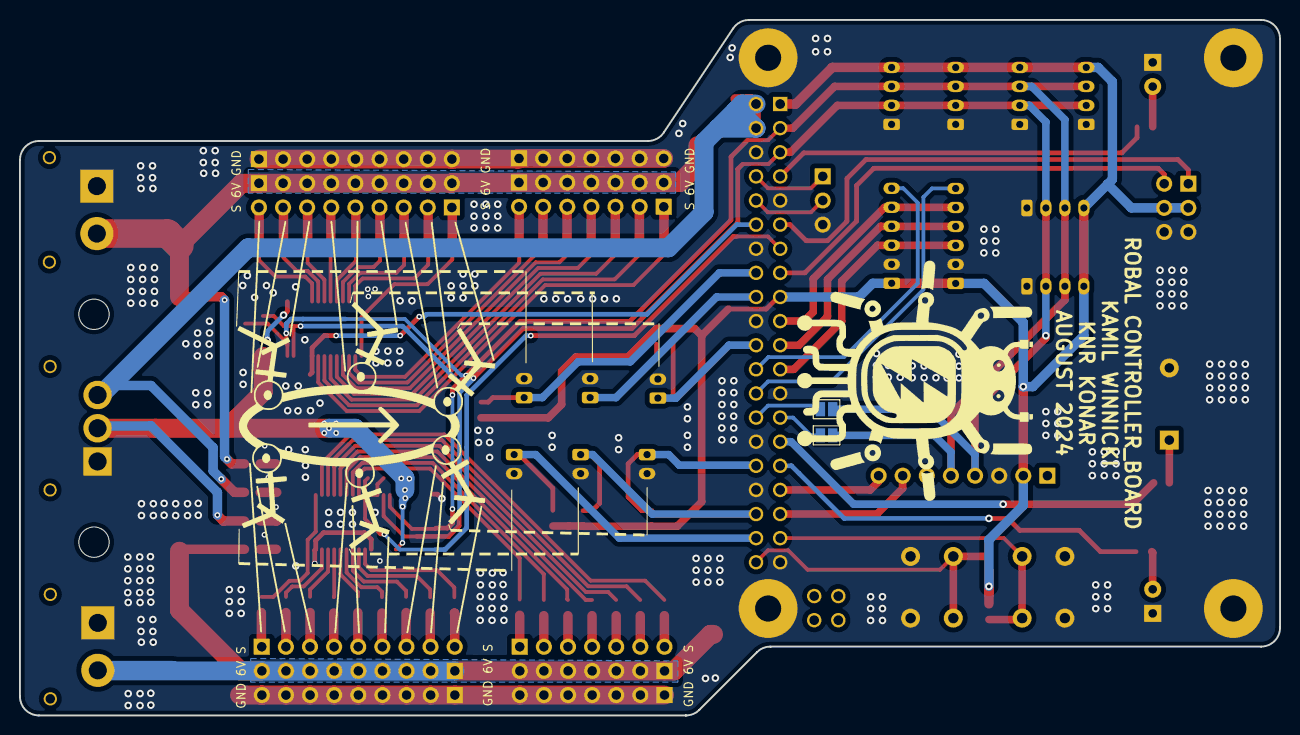
[picture p68: board robal_rpi_ioBoard.kicad_pcb from below]

Board: 2 copper layers, 132.7 x 73.2 mm, 111 parts (2 on the bottom side), 105 nets.

Parts:
3.3V1, 5V1, 6V_1, 6V_2: LED; LED_0603_1608Metric
BZ1: Buzzer; Buzzer_12x9.5RM7.6
C1, C4: 10uF; C_0805_2012Metric
C2, C5, C7, C9, C10, C13: >1mF; CP_EIA-3528-21_Kemet-B
C3, C6, C11, C12: >1mF; CP_Elec_10x10.5
D2, D7: LED; LED_D5.0mm
GY-87: GY-87
J1: Conn_01x03_Pin; PinHeader_1x03_P2.54mm_Vertical
J2, J3: Conn_01x02_Socket; AMASS_XT30PW-F_1x02_P2.50mm_Horizontal
J4: Conn_01x03_Socket; AMASS_MR30PW-FB_1x03_P3.50mm_Horizontal
J5, J6, J7, J8, J10, J11: Conn_01x04_Socket; JST_PH_B4B-PH-K_1x04_P2.00mm_Vertical
J9: Conn_02x03_Counter_Clockwise; PinHeader_2x03_P2.54mm_Vertical
JP1, JP2: Jumper_2_Open; SolderJumper-2_P1.3mm_Open_Pad1.0x1.5mm
PCA_1, PCA_2: PCA9685PW; TSSOP-28_4.4x9.7mm_P0.65mm
PCA_1_G_CONN1: PCA_1_G1; PinHeader_1x09_P2.54mm_Vertical
PCA_1_G_CONN2: PCA_1_G2; PinHeader_1x07_P2.54mm_Vertical
PCA_1_S_CONN1: PCA_1_S1; PinHeader_1x09_P2.54mm_Vertical
PCA_1_S_CONN2: PCA_1_S2; PinHeader_1x07_P2.54mm_Vertical
PCA_1_V_CONN1: PCA_1_V1; PinHeader_1x09_P2.54mm_Vertical
PCA_1_V_CONN2: PCA_1_V2; PinHeader_1x07_P2.54mm_Vertical
PCA_2_G_CONN1: PCA_2_G1; PinHeader_1x09_P2.54mm_Vertical
PCA_2_G_CONN2: PCA_2_G2; PinHeader_1x07_P2.54mm_Vertical
PCA_2_S_CONN1: PCA_2_S1; PinHeader_1x09_P2.54mm_Vertical
PCA_2_S_CONN2: PCA_2_S2; PinHeader_1x07_P2.54mm_Vertical
PCA_2_V_CONN1: PCA_2_V1; PinHeader_1x09_P2.54mm_Vertical
PCA_2_V_CONN2: PCA_2_V2; PinHeader_1x07_P2.54mm_Vertical
R1, R2, R3, R22, R23, R24, R46, R47, R48, R49, R50, R51, R52, R53: 10K; R_0603_1608Metric
R4, R27: 2K; R_0603_1608Metric
R5, R6, R7, R8, R9, R10, R11, R12, R13, R14, R15, R16, R17, R18, R19, R20, R29, R30, R31, R32, R33, R34, R35, R36, R37, R38, R39, R40, R41, R42, R43, R44: 220; R_0603_1608Metric
R21, R25, R26, R28: 500; R_0603_1608Metric
R45: 1K; R_0603_1608Metric
SPI_CONN0, SPI_CONN1: SPI_CONN; JST_PH_B6B-PH-K_1x06_P2.00mm_Vertical
SW1, SW2: SW_Omron_B3FS; SW_PUSH_6mm
TS_1, TS_2, TS_3, TS_4, TS_5, TS_6: TS_socket; JST_PH_B2B-PH-K_1x02_P2.00mm_Vertical
U1: RASPBERRY_PI_4B_4GB; MODULE_RASPBERRY_PI_4B_4GB

Connections:
+3.3V: C1.1, C4.1, C7.1, J4.2, PCA_1.1 (A0), PCA_1.28 (VDD), PCA_2.2 (A1), PCA_2.28 (VDD), R2.2, R3.1, R23.2, R24.1, R26.2
+3.3V_RP: GY-87.2 (3.3V), J5.4, J6.4, J7.4, J8.4, J9.3, J9.4, J10.4, J11.4, R46.2, R47.2, R48.2, R49.1, R50.1, R51.2, R52.2, R53.2, SPI_CONN0.1, SPI_CONN1.1, U1.1 (3V3), U1.17 (3V3)
+5V: C13.1, J4.3, R28.2, U1.2 (5V), U1.4 (5V)
+6V_1: C2.1, C3.1, C5.1, C12.1, J2.2, PCA_1_V_CONN1.1, PCA_1_V_CONN1.2, PCA_1_V_CONN1.3, PCA_1_V_CONN1.4, PCA_1_V_CONN1.5, PCA_1_V_CONN1.6, PCA_1_V_CONN1.7, PCA_1_V_CONN1.8, PCA_1_V_CONN1.9, PCA_1_V_CONN2.1, PCA_1_V_CONN2.2, PCA_1_V_CONN2.3, PCA_1_V_CONN2.4, PCA_1_V_CONN2.5, PCA_1_V_CONN2.6, PCA_1_V_CONN2.7, R4.2
+6V_2: C6.1, C9.1, C10.1, C11.1, J3.2, PCA_2_V_CONN1.1, PCA_2_V_CONN1.2, PCA_2_V_CONN1.3, PCA_2_V_CONN1.4, PCA_2_V_CONN1.5, PCA_2_V_CONN1.6, PCA_2_V_CONN1.7, PCA_2_V_CONN1.8, PCA_2_V_CONN1.9, PCA_2_V_CONN2.1, PCA_2_V_CONN2.2, PCA_2_V_CONN2.3, PCA_2_V_CONN2.4, PCA_2_V_CONN2.5, PCA_2_V_CONN2.6, PCA_2_V_CONN2.7, R27.2
BUZZ: R45.1, U1.29 (GPIO5)
D0: J9.2, U1.15 (GPIO22/GPIO_GEN3)
D1: J9.1, U1.11 (GPIO17/GPIO_GEN0)
DRDY: GY-87.8 (DRDY), U1.33 (GPIO13)
GND: 3.3V1.1 (K), 5V1.1 (K), 6V_1.1 (K), 6V_2.1 (K), BZ1.2 (-), C1.2, C2.2, C3.2, C4.2, C5.2, C6.2, C7.2, C9.2, C10.2, C11.2, C12.2, C13.2, D2.1 (K), D7.1 (K), GY-87.3 (GND), J1.3, J2.1, J3.1, J4.1, J5.1, J6.1, J7.1, J8.1, J9.5, J9.6, J10.1, J11.1, PCA_1.2 (A1), PCA_1.3 (A2), PCA_1.4 (A3), PCA_1.5 (A4), PCA_1.14 (VSS), PCA_1.24 (A5), PCA_1.25 (EXTCLK), PCA_1_G_CONN1.1, PCA_1_G_CONN1.2, PCA_1_G_CONN1.3, PCA_1_G_CONN1.4, PCA_1_G_CONN1.5, PCA_1_G_CONN1.6, PCA_1_G_CONN1.7, PCA_1_G_CONN1.8, PCA_1_G_CONN1.9, PCA_1_G_CONN2.1, PCA_1_G_CONN2.2, PCA_1_G_CONN2.3, PCA_1_G_CONN2.4, PCA_1_G_CONN2.5, PCA_1_G_CONN2.6, PCA_1_G_CONN2.7, PCA_2.1 (A0), PCA_2.3 (A2), PCA_2.4 (A3), PCA_2.5 (A4), PCA_2.14 (VSS), PCA_2.24 (A5), PCA_2.25 (EXTCLK), PCA_2_G_CONN1.1, PCA_2_G_CONN1.2, PCA_2_G_CONN1.3, PCA_2_G_CONN1.4, PCA_2_G_CONN1.5, PCA_2_G_CONN1.6, PCA_2_G_CONN1.7, PCA_2_G_CONN1.8, PCA_2_G_CONN1.9, PCA_2_G_CONN2.1, PCA_2_G_CONN2.2, PCA_2_G_CONN2.3, PCA_2_G_CONN2.4, PCA_2_G_CONN2.5, PCA_2_G_CONN2.6, PCA_2_G_CONN2.7, R1.2, R22.2, SPI_CONN0.2, SPI_CONN1.2, SW1.2, SW2.2, TS_1.2, TS_2.2, TS_3.2, TS_4.2, TS_5.2, TS_6.2, U1.6 (GND), U1.9 (GND), U1.14 (GND), U1.20 (GND), U1.25 (GND), U1.30 (GND), U1.34 (GND), U1.39 (GND), U1.S1 (SHIELD), U1.S2 (SHIELD), U1.S3 (SHIELD), U1.S4 (SHIELD)
I2C_SCL: GY-87.4 (SCL), J5.2, J6.2, J7.2, J8.2, J10.2, J11.2, JP2.1 (A), PCA_1.26 (SCL), PCA_2.26 (SCL), R3.2, R24.2, U1.5 (GPIO3/SCL1)
I2C_SDA: GY-87.5 (SDA), J5.3, J6.3, J7.3, J8.3, J10.3, J11.3, JP1.1 (A), PCA_1.27 (SDA), PCA_2.27 (SDA), R2.1, R23.1, U1.3 (GPIO2/SDA1)
INTA_MPU: GY-87.7 (INTA), U1.35 (GPIO19)
unnamed: 3.3V1.2 (A), R26.1
unnamed: 5V1.2 (A), R28.1
unnamed: 6V_1.2 (A), R4.1
unnamed: 6V_2.2 (A), R27.1
unnamed: BZ1.1 (+), R45.2
unnamed: D2.2 (A), R21.1
unnamed: D7.2 (A), R25.1
unnamed: JP1.2 (B), U1.27 (ID_SD)
unnamed: JP2.2 (B), U1.28 (ID_SC)
unnamed: PCA_1.6 (LED0), R5.1
unnamed: PCA_1.7 (LED1), R11.1
unnamed: PCA_1.8 (LED2), R16.1
unnamed: PCA_1.9 (LED3), R6.1
unnamed: PCA_1.10 (LED4), R12.1
unnamed: PCA_1.11 (LED5), R17.1
unnamed: PCA_1.12 (LED6), R7.1
unnamed: PCA_1.13 (LED7), R13.1
unnamed: PCA_1.15 (LED8), R18.1
unnamed: PCA_1.16 (LED9), R8.1
unnamed: PCA_1.17 (LED10), R14.1
unnamed: PCA_1.18 (LED11), R19.1
unnamed: PCA_1.19 (LED12), R9.1
unnamed: PCA_1.20 (LED13), R15.1
unnamed: PCA_1.21 (LED14), R20.1
unnamed: PCA_1.22 (LED15), R10.1
unnamed: PCA_1_S_CONN1.1, R18.2
unnamed: PCA_1_S_CONN1.2, R13.2
unnamed: PCA_1_S_CONN1.3, R7.2
unnamed: PCA_1_S_CONN1.4, R17.2
unnamed: PCA_1_S_CONN1.5, R12.2
unnamed: PCA_1_S_CONN1.6, R6.2
unnamed: PCA_1_S_CONN1.7, R16.2
unnamed: PCA_1_S_CONN1.8, R11.2
unnamed: PCA_1_S_CONN1.9, R5.2
unnamed: PCA_1_S_CONN2.1, R10.2
unnamed: PCA_1_S_CONN2.2, R20.2
unnamed: PCA_1_S_CONN2.3, R15.2
unnamed: PCA_1_S_CONN2.4, R9.2
unnamed: PCA_1_S_CONN2.5, R19.2
unnamed: PCA_1_S_CONN2.6, R14.2
unnamed: PCA_1_S_CONN2.7, R8.2
unnamed: PCA_2.6 (LED0), R29.1
unnamed: PCA_2.7 (LED1), R35.1
unnamed: PCA_2.8 (LED2), R40.1
unnamed: PCA_2.9 (LED3), R30.1
unnamed: PCA_2.10 (LED4), R36.1
unnamed: PCA_2.11 (LED5), R41.1
unnamed: PCA_2.12 (LED6), R31.1
unnamed: PCA_2.13 (LED7), R37.1
unnamed: PCA_2.15 (LED8), R42.1
unnamed: PCA_2.16 (LED9), R32.1
unnamed: PCA_2.17 (LED10), R38.1
unnamed: PCA_2.18 (LED11), R43.1
unnamed: PCA_2.19 (LED12), R33.1
unnamed: PCA_2.20 (LED13), R39.1
unnamed: PCA_2.21 (LED14), R44.1
unnamed: PCA_2.22 (LED15), R34.1
unnamed: PCA_2_S_CONN1.1, R42.2
unnamed: PCA_2_S_CONN1.2, R37.2
unnamed: PCA_2_S_CONN1.3, R31.2
unnamed: PCA_2_S_CONN1.4, R41.2
unnamed: PCA_2_S_CONN1.5, R36.2
unnamed: PCA_2_S_CONN1.6, R30.2
unnamed: PCA_2_S_CONN1.7, R40.2
unnamed: PCA_2_S_CONN1.8, R35.2
unnamed: PCA_2_S_CONN1.9, R29.2
unnamed: PCA_2_S_CONN2.1, R34.2
unnamed: PCA_2_S_CONN2.2, R44.2
unnamed: PCA_2_S_CONN2.3, R39.2
unnamed: PCA_2_S_CONN2.4, R33.2
unnamed: PCA_2_S_CONN2.5, R43.2
unnamed: PCA_2_S_CONN2.6, R38.2
unnamed: PCA_2_S_CONN2.7, R32.2
PCA_1_OE: PCA_1.23 (~OE), R1.1, U1.13 (GPIO27/GPIO_GEN2)
PCA_2_OE: PCA_2.23 (~OE), R22.1, U1.12 (GPIO18/GPIO_GEN1)
SPI_CE0: SPI_CONN0.6, U1.24 (GPIO8/~SPI_CE0)
SPI_CE1: SPI_CONN1.6, U1.26 (GPIO7/~SPI_CE1)
SPI_MISO: SPI_CONN0.4, SPI_CONN1.4, U1.21 (GPIO9/SPI_MISO)
SPI_MOSI: SPI_CONN0.5, SPI_CONN1.5, U1.19 (GPIO10/SPI_MOSI)
SPI_SCLK: SPI_CONN0.3, SPI_CONN1.3, U1.23 (GPIO11/SPI_SCLK)
TS_1: R46.1, TS_1.1, U1.32 (GPIO12)
TS_2: R51.1, TS_4.1, U1.22 (GPIO25/GPIO_GEN6)
TS_3: R47.1, TS_2.1, U1.36 (GPIO16)
TS_4: R52.1, TS_5.1, U1.18 (GPIO24/GPIO_GEN5)
TS_5: R48.1, TS_3.1, U1.38 (GPIO20)
TS_6: R53.1, TS_6.1, U1.16 (GPIO23/GPIO_GEN4)
UART_RX: J1.2, U1.10 (GPIO15/RXD0)
UART_TX: J1.1, U1.8 (GPIO14/TXD0)
U_BUTTON1: R49.2, SW1.1, U1.40 (GPIO21)
U_BUTTON2: R50.2, SW2.1, U1.37 (GPIO26)
U_LED1: R25.2, U1.31 (GPIO6)
U_LED2: R21.2, U1.7 (GPIO4/GPIO_GCKL)
