KamilWuu/Robal-2.0/electronics/robal_power_board/robal_power_board.kicad_pcb

## KiCad design electronics/robal_power_board/robal_power_board.kicad_pcb (2024-12-04)

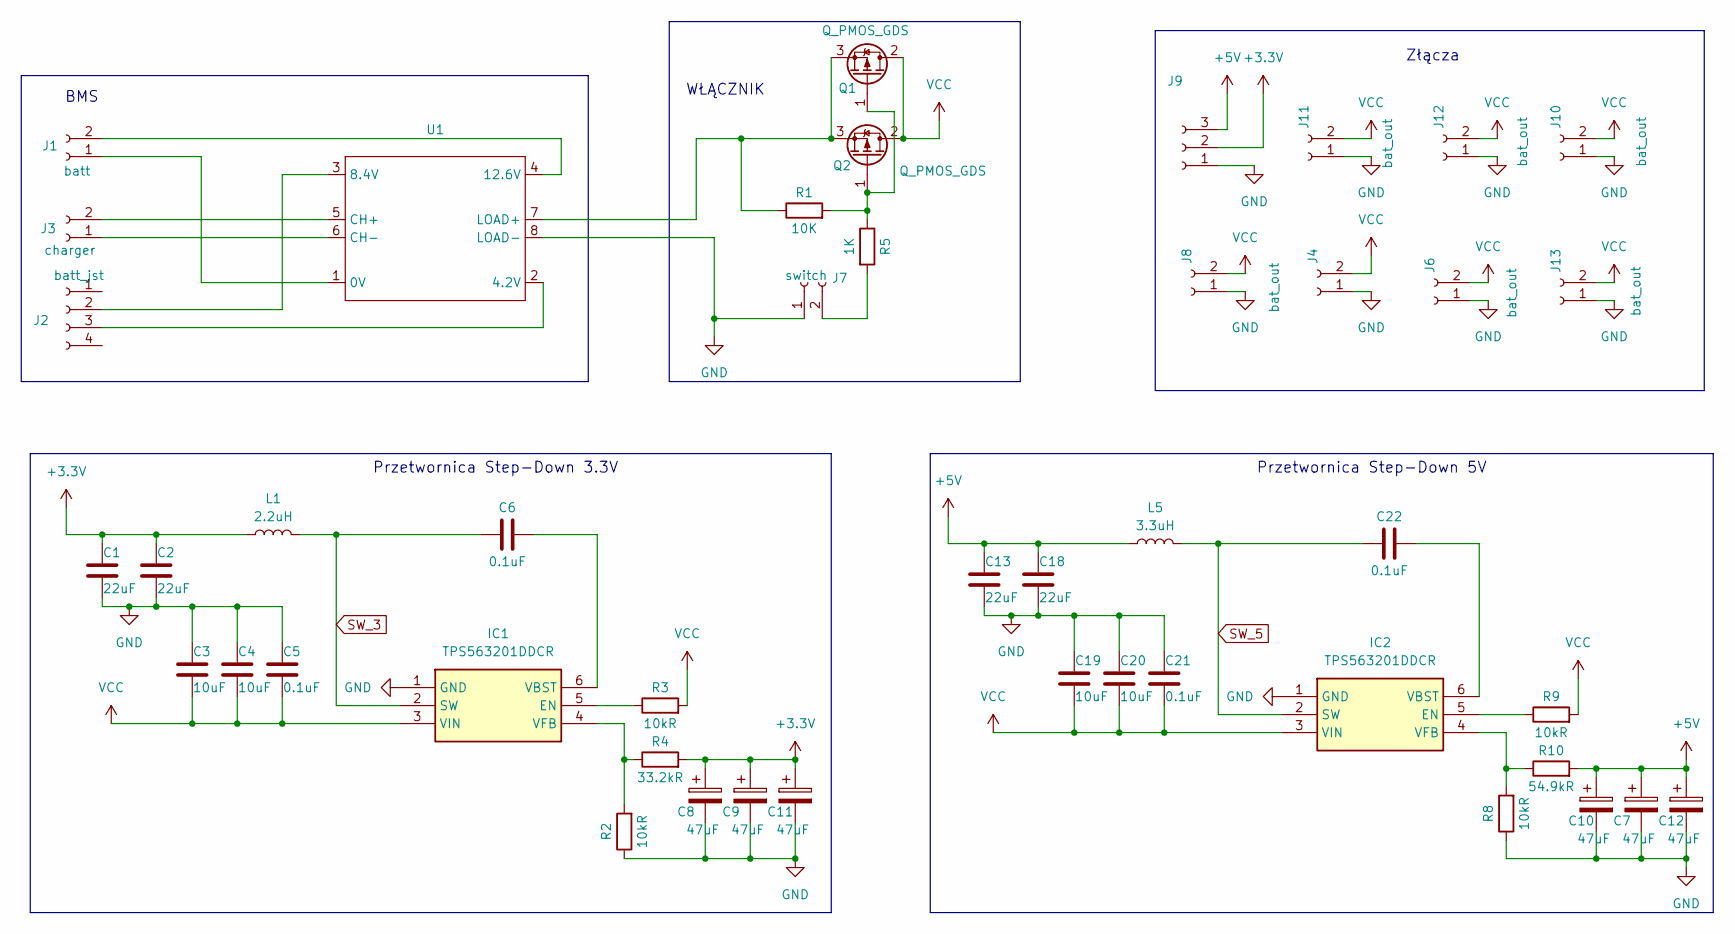
[picture p69: schematic robal_power_board.kicad_sch, Robal Power Board]

Parts:
C1, C2, C13, C18: 22uF; C_0805_2012Metric
C3, C4, C19, C20: 10uF; C_0805_2012Metric
C5, C6, C21, C22: 0.1uF; C_0603_1608Metric
C7, C8, C9, C10, C11, C12: 47uF; CP_EIA-3528-21_Kemet-B_Pad1.50x2.35mm_HandSolder
IC1, IC2: TPS563201DDCR; SOT-23-6; Manufacturer_Part_Number TPS563201DDCR
J1: batt; AMASS_XT60PW-M_1x02_P7.20mm_Horizontal
J2: batt_jst; JST_XH_S4B-XH-A_1x04_P2.50mm_Horizontal
J3: charger; AMASS_XT30PW-F_1x02_P2.50mm_Horizontal
J4: SENSOR_BOARD; AMASS_XT30PW-F_1x02_P2.50mm_Horizontal
J6, J8, J10, J13: bat_out; JST_PH_B2B-PH-K_1x02_P2.00mm_Vertical
J7: switch; JST_PH_B2B-PH-K_1x02_P2.00mm_Vertical
J9: Conn_01x03_Socket; AMASS_MR30PW-FB_1x03_P3.50mm_Horizontal
J11, J12: bat_out; AMASS_XT30PW-F_1x02_P2.50mm_Horizontal
L1: 2.2uH; L_Bourns_SRP7028A_7.3x6.6mm
L5: 3.3uH; L_SXN_SMDRI125
Q1, Q2: Q_PMOS_GDS; DFN5X6_AON6403
R1: 10K; R_0603_1608Metric
R2, R3, R8, R9: 10kR; R_0603_1608Metric
R4: 33.2kR; R_0603_1608Metric
R5: 1K; R_0603_1608Metric
R10: 54.9kR; R_0603_1608Metric
U1: 3S_BMS

Connections:
+3.3V: C1.2, C2.2, C8.1, C9.1, C11.1, J9.2, L1.1, R4.2
+5V: C7.1, C10.1, C12.1, C13.2, C18.2, J9.3, L5.1, R10.2
GND: C1.1, C2.1, C3.2, C4.2, C5.2, C7.2, C8.2, C9.2, C10.2, C11.2, C12.2, C13.1, C18.1, C19.2, C20.2, C21.2, IC1.1 (GND), IC2.1 (GND), J4.1, J6.1, J7.1, J8.1, J9.1, J10.1, J11.1, J12.1, J13.1, R2.1, R8.1, U1.8 (LOAD-); also elsewhere on the board
unnamed: IC1.5 (EN), R3.1
unnamed: C6.2, IC1.6 (VBST)
unnamed: IC1.4 (VFB), R2.2, R4.1
unnamed: IC2.5 (EN), R9.1
unnamed: C22.2, IC2.6 (VBST)
unnamed: IC2.4 (VFB), R8.2, R10.1
unnamed: J1.1, U1.1 (0V)
unnamed: J1.2, U1.4 (12.6V)
unnamed: J2.2, U1.3 (8.4V)
unnamed: J2.3, U1.2 (4.2V)
unnamed 13: J3.1, U1.6 (CH-); also elsewhere on the board
unnamed 14: J3.2, U1.5 (CH+); also elsewhere on the board
unnamed 15: J7.2, R5.2; also elsewhere on the board
unnamed: Q1.1 (G), Q2.1 (G), R1.2, R5.1
unnamed: Q1.3 (S), Q2.3 (S), R1.1, U1.7 (LOAD+)
SW_3: C6.1, IC1.2 (SW), L1.2
SW_5: C22.1, IC2.2 (SW), L5.2
VCC: C3.1, C4.1, C5.1, C19.1, C20.1, C21.1, IC1.3 (VIN), IC2.3 (VIN), J4.2, J6.2, J8.2, J10.2, J11.2, J12.2, J13.2, Q1.2 (D), Q2.2 (D), R3.2, R9.2; also elsewhere on the board

Notes on the sheet:
BMS
Złącza
Przetwornica Step-Down 5V
WŁĄCZNIK
Przetwornica Step-Down 3.3V

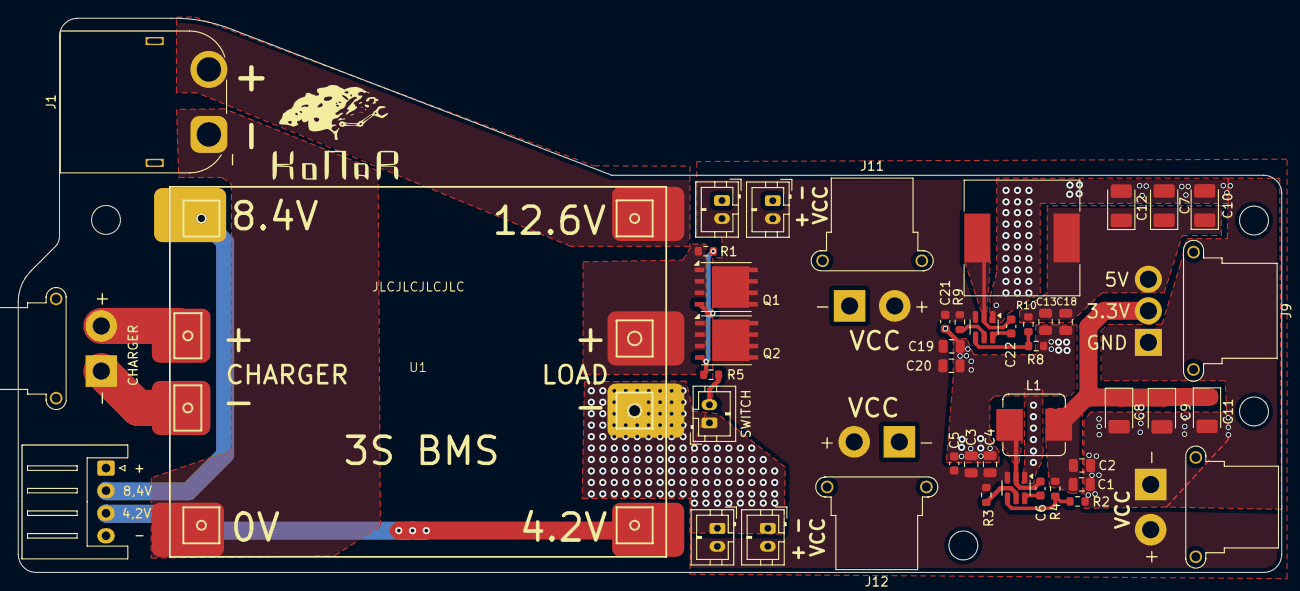
[picture p70: board robal_power_board.kicad_pcb from above]

Board: 2 copper layers, 140.0 x 61.4 mm, 45 parts (0 on the bottom side), 21 nets.

Other parts of the board:
CHARGER: charger; AMASS_XT30PW-F_1x02_P2.50mm_Horizontal
SENSOR_BOARD: SENSOR_BOARD; AMASS_XT30PW-F_1x02_P2.50mm_Horizontal
SWITCH: switch; JST_PH_B2B-PH-K_1x02_P2.00mm_Vertical

Their connections:
GND: SENSOR_BOARD.1, SWITCH.1; also elsewhere on the board
unnamed 13: CHARGER.1; also elsewhere on the board
unnamed 14: CHARGER.2; also elsewhere on the board
unnamed 15: SWITCH.2; also elsewhere on the board
VCC: SENSOR_BOARD.2; also elsewhere on the board
