KamilWuu/Robal-2.0/(commit log)

2024-07-04 utworzono wstepny projekt nóg i glownej konstrukcji nośnej
    [Bashing_3S1P_11.1V_5000mAH_60c.0001.ipt, Bashing_3S1P_11.1V_5000mAH_60c.ipt, DC-DC Step Down Buck Converter CC-CV 300W 9A.ipt, Lithium Battery Capacity Indicator Module.0001.ipt, Lithium Battery Capacity Indicator Module.ipt, ROBAL_2.0_assembly_01.0007.iam, ROBAL_2.0_assembly_01.iam, Standard-Servo.0006.ipt]
2024-07-04 utworzono wstępny schemat plytki glownej
    [robal_rpi_ioBoard.kicad_pcb, robal_rpi_ioBoard.kicad_sch]
2024-07-05 dodano wiecej zlacz dla i2c
    [robal_rpi_ioBoard.kicad_pcb, robal_rpi_ioBoard.kicad_sch]
2024-07-06 rozpoczeto schemat plytki zasilania
    [5vsd_sketch.dxf, 60A3S_BMS.ipt, 60A3S_BMS.stp, ROBAL_2.0_assembly_01.0007.iam, ROBAL_2.0_assembly_01.0009.iam, ROBAL_2.0_assembly_01.iam, bms_sketch.dxf, czlon3_pre_MIR1.0001.ipt]
2024-07-06 dokonczono wstepny schemat plytki zasilajacej
    [5vsd_sketch.dxf, Amass_XT30PW-M_pcb solder.stp, MR30PW.step, XT60PW FEMALE.STEP, XT60PW MALE.STEP, robal_power_board.kicad_pcb, robal_power_board.kicad_sch]
2024-07-07 drobne zmiany
    [ROBAL_2.0_assembly_01.0009.iam, ROBAL_2.0_assembly_01.0010.iam, ROBAL_2.0_assembly_01.iam, robal_power_board.kicad_pcb]
2024-07-07 utworzono wstepny layout plytki zasilania
    [robal_power_board.kicad_pcb, robal_power_board.kicad_sch]
2024-07-08 zmiany w layoucie
    [robal_power_board.kicad_pcb]
2024-07-09 dodano mosfet
    [robal_power_board.kicad_sch]
2024-07-09 ukonczono pierwsza wersje layoutu na power board
    [drc.kicad_pcb, robal_power_board.kicad_pcb, robal_power_board.kicad_sch]
2024-07-11 poprawiono layout przetwornicy
    [robal_power_board.kicad_pcb, robal_power_board.kicad_sch]
2024-07-13 dodano nowa przetwornice, zmieniono layout
    [cewka.0003.ipt, cewka.ipt, cewka.stp, robal_power_board.kicad_pcb, robal_power_board.kicad_sch]
2024-07-21 zmiany w mechanice
    [ROBAL_2.0_assembly_01.0011.iam, ROBAL_2.0_assembly_01.0012.iam, ROBAL_2.0_assembly_01.iam, Standard-Servo.0006.ipt, Standard-Servo.0007.ipt, Standard-Servo.ipt, czlon2_pre.0004.ipt, czlon2_pre.0006.ipt]
2024-07-22 zmieniono montaz orczykow
    [ROBAL_2.0_assembly_01.0012.iam, ROBAL_2.0_assembly_01.0014.iam, ROBAL_2.0_assembly_01.iam, SERVO ARM HORN 25T ALUMINIUM.ipt, Standard-Servo.0007.ipt, Standard-Servo.0008.ipt, Standard-Servo.ipt, Standard-Servo_MIR3.0001.ipt]
2024-07-23 poprawiono 2 i 3 czlon
    [ROBAL_2.0_assembly_01.0014.iam, ROBAL_2.0_assembly_01.0015.iam, ROBAL_2.0_assembly_01.iam, czlon2_pre_MIR2.0002.ipt, czlon2_pre_MIR2.0003.ipt, czlon2_pre_MIR2.ipt, czlon3_pre.0012.ipt, czlon3_pre.0016.ipt]
2024-07-24 zmiany w uchwycie serw
    [Micro Limit Switch.STEP, Micro Limit Switch.ipt, ROBAL_2.0_assembly_01.0015.iam, ROBAL_2.0_assembly_01.0016.iam, ROBAL_2.0_assembly_01.iam, czlon3_pre_MIR1.0003.ipt, czlon3_pre_MIR1.0004.ipt, czlon3_pre_MIR1.ipt]
2024-07-25 zmieniono przetwornice na 5V
    [robal_power_board.kicad_pcb, robal_power_board.kicad_sch]
2024-07-27 nowa wersja plytki zasilania wersja nie pamietam ktora
    [60A3S_BMS.0001.ipt, 60A3S_BMS.ipt, MR30PW-FB v2.step, ROBAL_2.0_assembly_01.0016.iam, ROBAL_2.0_assembly_01.0017.iam, ROBAL_2.0_assembly_01.iam, Sub-Assy Buck Converter.ipt, XT30PW-F.STEP]
2024-07-28 rozmieszczenie sekcji zasilania w robocie
    [pokrywa_przod.ipt, pokrywa_tyl.0003.ipt, pokrywa_tyl.ipt, uchwyt_serwa_podwojny.0011.ipt, uchwyt_serwa_podwojny.0015.ipt, uchwyt_serwa_podwojny.ipt, uchwyt_serwa_podwojny_MIR.0005.ipt, uchwyt_serwa_podwojny_MIR.0007.ipt]
2024-07-31 pierwsza skonczona wersja obudowy
    [dol.0005.ipt, dol.0006.ipt, dol.ipt, dol.stl, gora.0007.ipt, gora.0009.ipt, gora.ipt, gora.stl]
2024-07-31 poprawki w uchwytach serw
    [czlon2_pre.stl, czlon3_pre.stl, dol.0006.ipt, dol.0007.ipt, dol.ipt, gora.0009.ipt, gora.0011.ipt, gora.ipt]
2024-07-31 zmiany zmiany gotowy 1 czlon
    [czlon1_lewy.stl, czlon1_lewy_color_1.stl, czlon1_lewy_color_2.stl, czlon1_lewy_color_3.stl, czlon2_pre.0013.ipt, czlon2_pre.0015.ipt, czlon2_pre.ipt, czlon_2_wciecie_1.0002.ipt]
2024-08-02 zmiany w ostatnim czlonie
    [but.0002.ipt, but.ipt, czlon2_lewy.3mf, czlon2_lewy.stl, czlon2_lewy_color_1.stl, czlon2_lewy_color_2.stl, czlon2_lewy_w_color.3mf, czlon2_pre.0015.ipt]
2024-08-02 NOGI SKONCZONE
    [but.0002.ipt, but.0004.ipt, but.ipt, czlon4_2_wciecie_1.0001.ipt, czlon4_2_wciecie_1.ipt, czlon4_pre_2.0012.ipt, czlon4_pre_2.0014.ipt, czlon4_pre_2.ipt]
2024-08-04 prace nad plytka zasilania
    [czlon2_pre.0017.ipt, czlon2_pre.0018.ipt, czlon2_pre.ipt, czlon3_pre.0018.ipt, czlon3_pre.0019.ipt, czlon3_pre.ipt, czlon_2_wciecie_1.0002.ipt, czlon_2_wciecie_1.0003.ipt]
2024-08-11 plytka sterujaca prawie skonczona
    [robal_power_board.kicad_pcb, robal_rpi_ioBoard.kicad_pcb, robal_rpi_ioBoard.kicad_sch]
2024-08-12 plytka sterujaca wstepnie skonczona
    [robal_rpi_ioBoard.kicad_pcb, robal_rpi_ioBoard.kicad_sch, robal_rpi_ioBoard.step, rpi_board_obrys.dxf]
2024-08-17 plytki wstepnie gotowe do produkcji
    [robal_power_board-B_Cu.gbr, robal_power_board-B_Mask.gbr, robal_power_board-B_Paste.gbr, robal_power_board-B_Silkscreen.gbr, robal_power_board-Edge_Cuts.gbr, robal_power_board-F_Cu.gbr, robal_power_board-F_Mask.gbr, robal_power_board-F_Paste.gbr]
2024-08-18 poprawki w elektronice 1
    [robal_power_board-B_Cu.gbr, robal_power_board-B_Mask.gbr, robal_power_board-B_Paste.gbr, robal_power_board-B_Silkscreen.gbr, robal_power_board-Edge_Cuts.gbr, robal_power_board-F_Cu.gbr, robal_power_board-F_Mask.gbr, robal_power_board-F_Paste.gbr]
2024-09-15 export 3d models
    [robal_power_board_7.step, robal_rpi_ioBoard.kicad_pcb]
2024-09-15 export 3d models2
    [robal_rpi_ioBoard.kicad_pcb]
2024-09-15 uchwyt na eletronike
    [Micro Limit Switch.0001.ipt, Micro Limit Switch.ipt, Micro Limit Switch_MIR.ipt, RPI.0003.iam, RPI.iam, SERVO ARM HORN 25T ALUMINIUM.0001.ipt, SERVO ARM HORN 25T ALUMINIUM.ipt, SERVO ARM HORN 25T ALUMINIUM_MIR.ipt]
2024-10-12 zmieniony tylny panel
    [RPI.0003.iam, RPI.0004.iam, RPI.iam, gora.0013.ipt, gora.0014.ipt, gora.ipt, podpora_imu.ipt, podpora_imu.stl]
2024-10-12 dodano testy i2c
2024-10-12 dodano defint touch sensors
2024-10-13 uwotrzono rysunki mechaniki i obrazki elektroniki
    [Micro Limit Switch.0001.ipt, Micro Limit Switch.0002.ipt, Micro Limit Switch.ipt, Micro Limit Switch_MIR1.ipt, RPI.iam, RPI_2.iam, SERVO ARM HORN 25T ALUMINIUM.0001.ipt, SERVO ARM HORN 25T ALUMINIUM.0002.ipt]
2024-10-13 wstepne funkcje sterowania serwami
    [robal_rpi_ioBoard.kicad_sch]
2024-10-18 poprawiono schematy
    [robal_power_board.kicad_sch, robal_rpi_ioBoard.kicad_sch]
2024-10-18 przerobiono panel tylny
    [L1.0001.ipt, L1.0002.ipt, L1.ipt, L2.0001.ipt, L2.0002.ipt, L2.ipt, POKRYWA_TYLNA.iam, ROBAL_MINI.0001.iam]
2024-10-20 utworzono szkielet kodu w posatci struktur dla nog i serw
    [RPI_2.0001.iam, RPI_2.0002.iam, RPI_2.iam]
2024-10-22 zaimplementowano kinematyke odwrotna
2024-10-22 prawdopodobnie naprawiono blad w kinematyce
2024-10-22 kinematyka-teraz bedzie dzialac!
2024-10-22 ROBOT WSTAJE NA KINEMATYCE!
2024-10-27 dodano pokrywe i naprawa gita
    [POKRYWA_TYLNA.0001.iam, POKRYWA_TYLNA.iam, RPI_2.0002.iam, RPI_2.0006.iam, RPI_2.iam, gora.0014.ipt, gora.0015.ipt, gora.ipt]
2024-10-29 edytowano podstawe i gore
    [RPI_2.0006.iam, RPI_2.0008.iam, RPI_2.iam, dol.0007.ipt, dol.0008.ipt, dol.ipt, dol.stl, gora.0015.ipt]
2024-11-01 elipsy dzialają, jednak dwa niesforne serwa stwarzają problemy
    [kinematics.h, main4.c, main5.c, robot.h, trajectory.h]
2024-11-22 dodano zapis wyników do csv
    [robot_motion.csv]
2024-11-22 test export
    [robot_motion.csv]
2024-11-22 test export2
    [robot_motion.csv]
2024-11-22 test export3
    [robot_motion.csv]
2024-11-22 test export4
    [robot_motion.csv]
2024-11-22 test export5
    [robot_motion.csv]
2024-12-02 poprawiono schematy elektroniczne
    [robal_power_board.kicad_pcb, robal_power_board.kicad_sch, robal_rpi_ioBoard.kicad_pcb, robal_rpi_ioBoard.kicad_sch]
2024-12-04 poprawiono but
    [but.0006.ipt, but.0007.ipt, but.ipt, but.stl]
2024-12-05 dodano obrazek
    [RPI_2.0008.iam, RPI_2.0009.iam, RPI_2.iam, but_MIR1.0001.ipt, but_MIR1.ipt, czlon_4_zloz.0008.iam, czlon_4_zloz.0009.iam, czlon_4_zloz.iam]
2024-12-20 dodano kod do generowania csv
    [robal_dane.csv]
2024-12-20 wygenerowano pliki csv
    [R_-100_V_20_leg_3.csv, R_-500_V_80_leg_3.csv, R_1000000000_V_80_leg_3.csv, R_1000_V_80_leg_3.csv, R_100_V_20_leg_0.csv, R_100_V_20_leg_1.csv, R_100_V_20_leg_2.csv, R_100_V_20_leg_3.csv]
